brkaysenturk/turret-fcs/analysis/figures/fig2_tuned_phase_plane_portrait.png

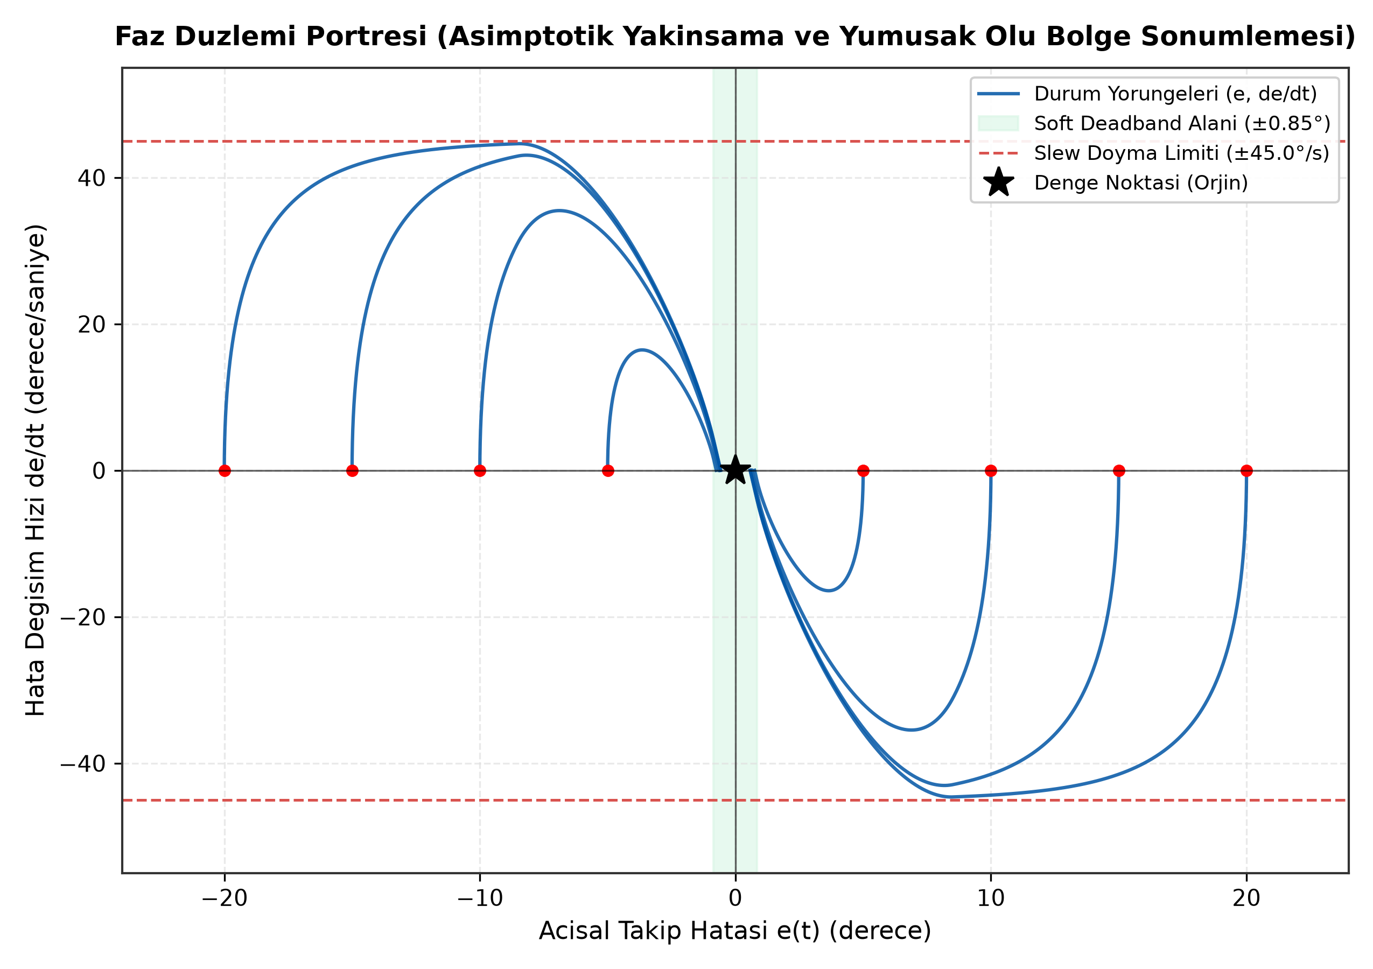
analysis/figures/fig2_tuned_phase_plane_portrait.png
