brkaysenturk/turret-fcs/analysis/figures/fig3_tuned_bode_stability.png

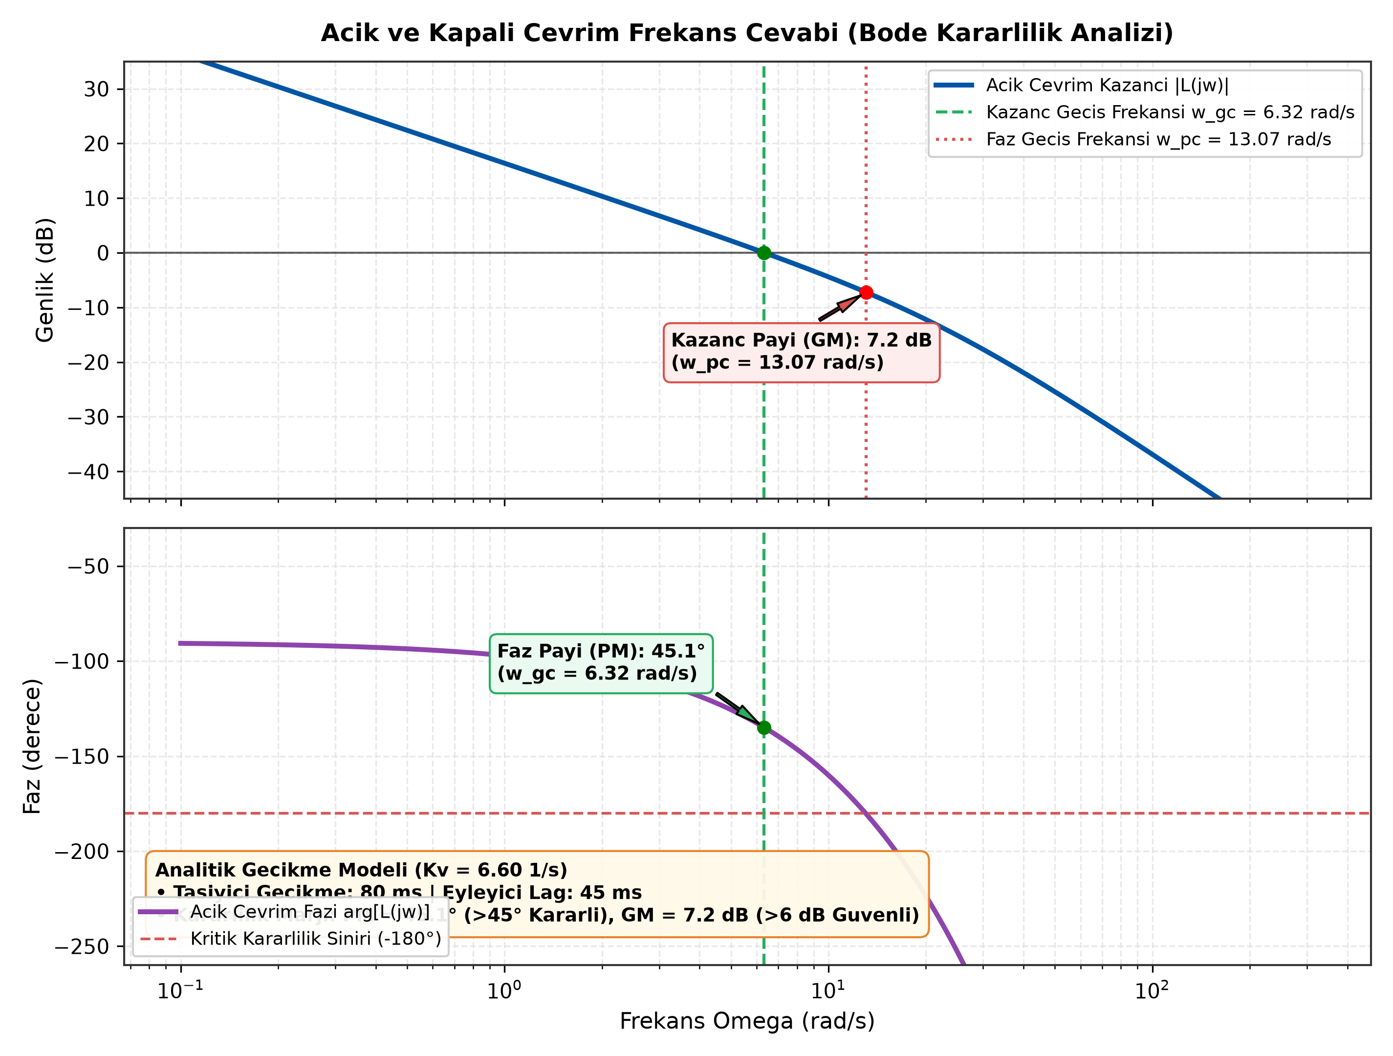
analysis/figures/fig3_tuned_bode_stability.png
