brkaysenturk/turret-fcs/analysis/figures/fig4_tuned_dynamic_tracking.png

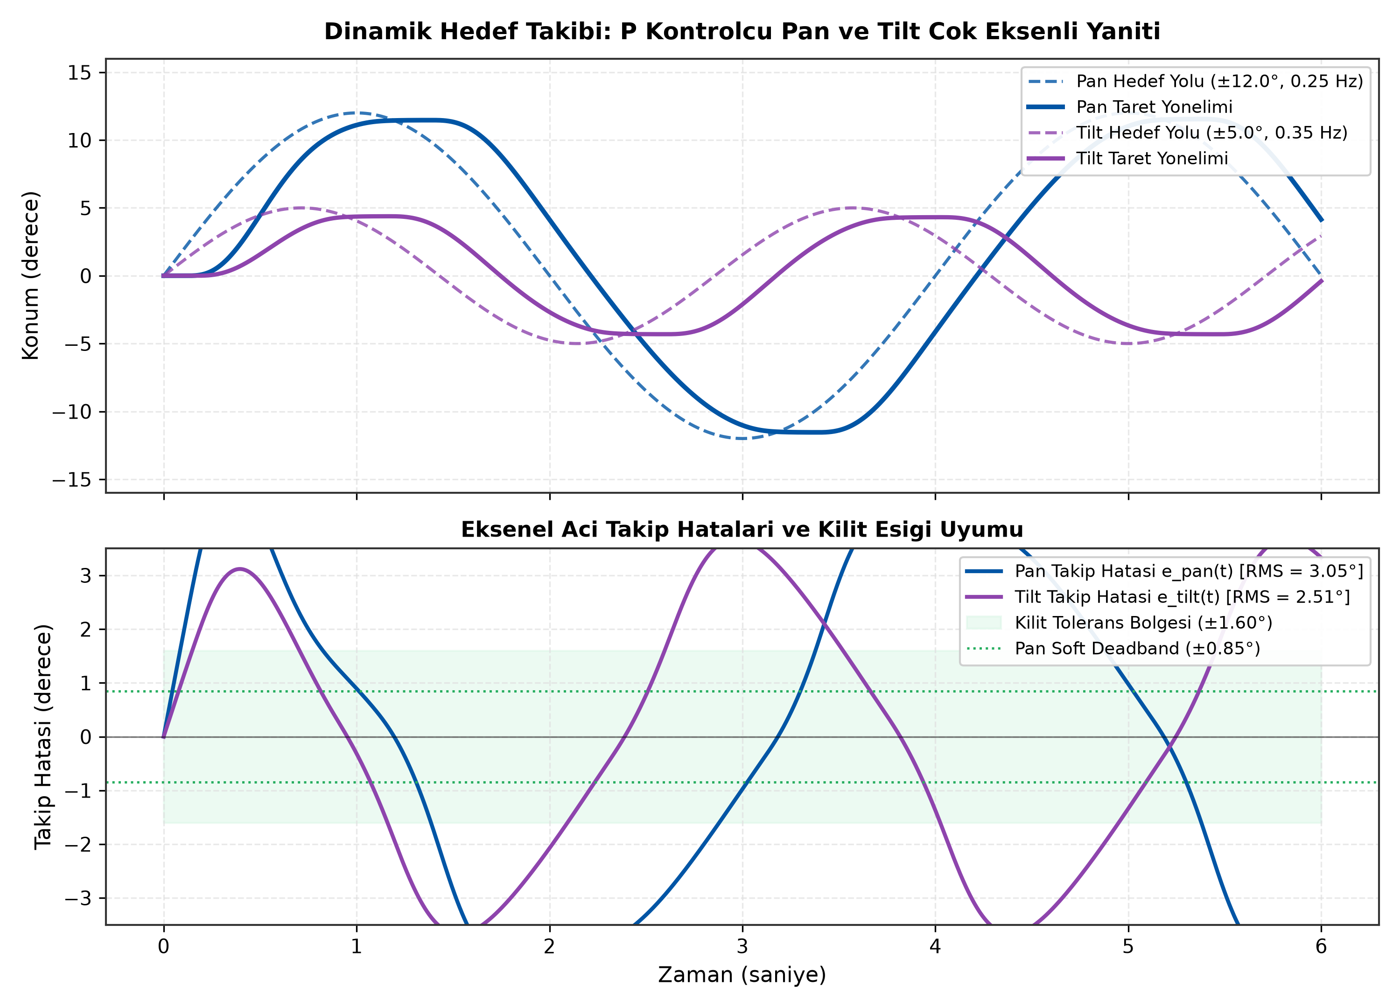
analysis/figures/fig4_tuned_dynamic_tracking.png
