brkaysenturk/turret-fcs/analysis/figures/fig5_tuned_lissajous_coverage.png

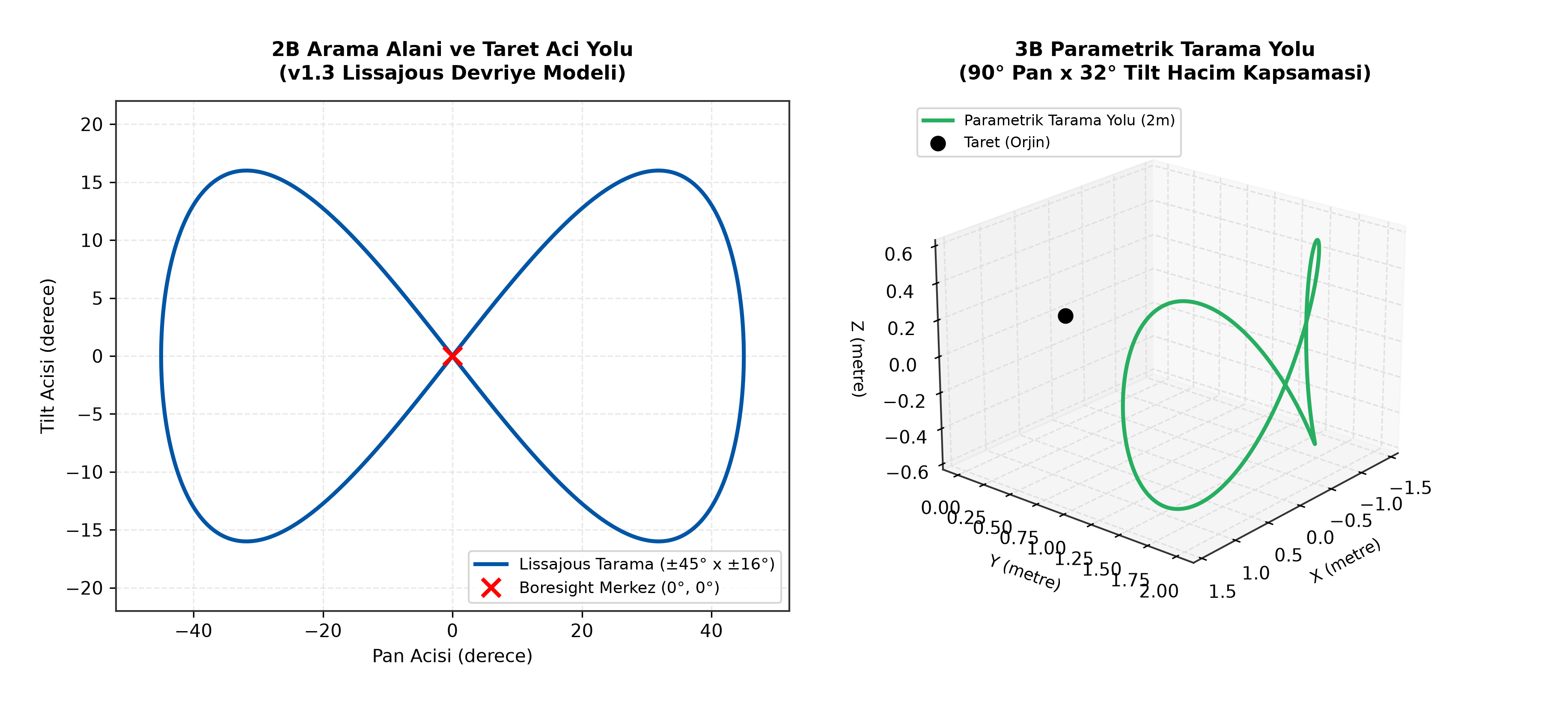
analysis/figures/fig5_tuned_lissajous_coverage.png
