brkaysenturk/turret-fcs/analysis/figures/fig7_real_hardware_still_lock.png

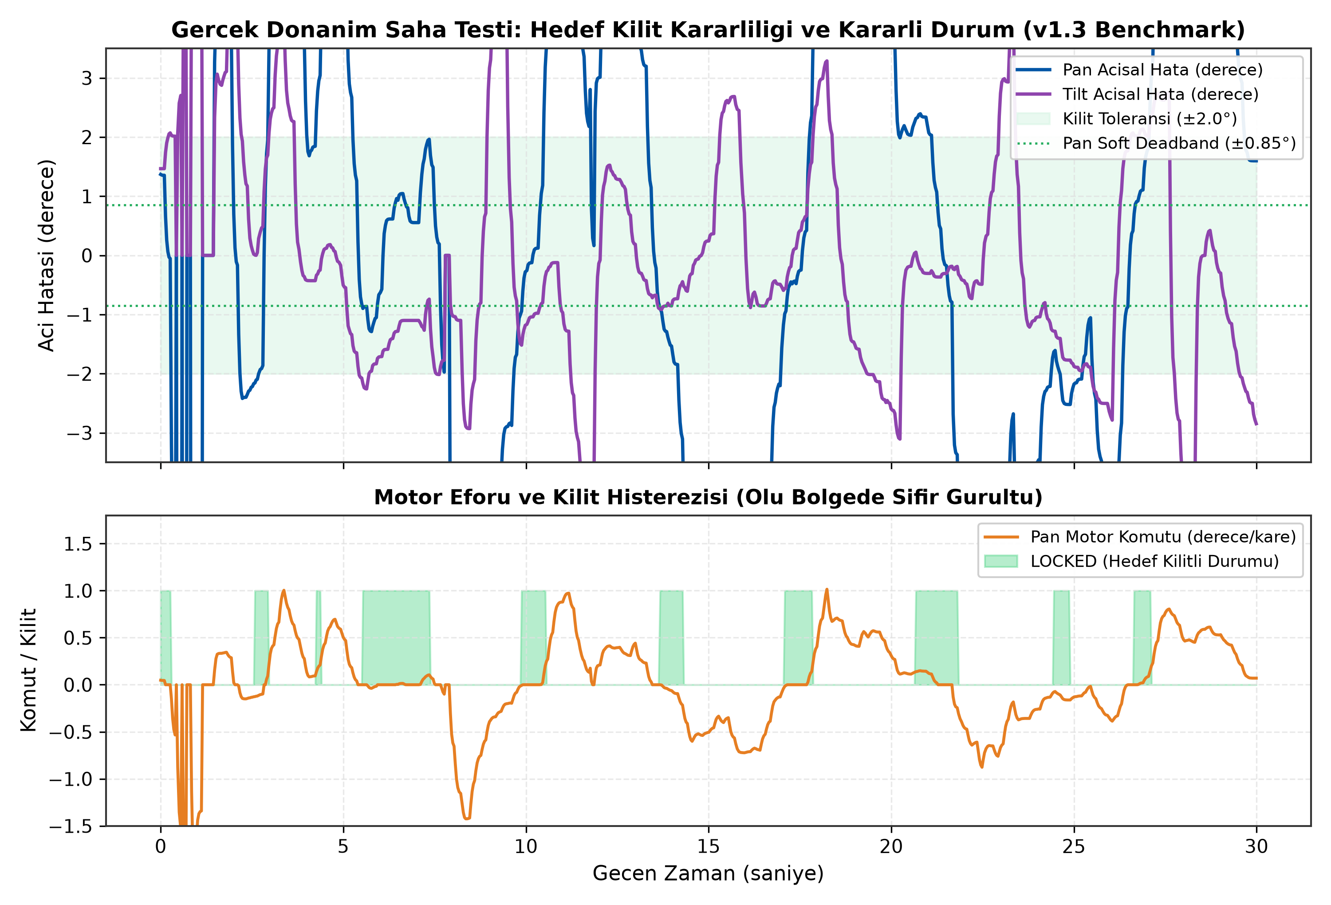
analysis/figures/fig7_real_hardware_still_lock.png
