brkaysenturk/turret-fcs/analysis/figures/fig8_real_hardware_moving_tracking.png

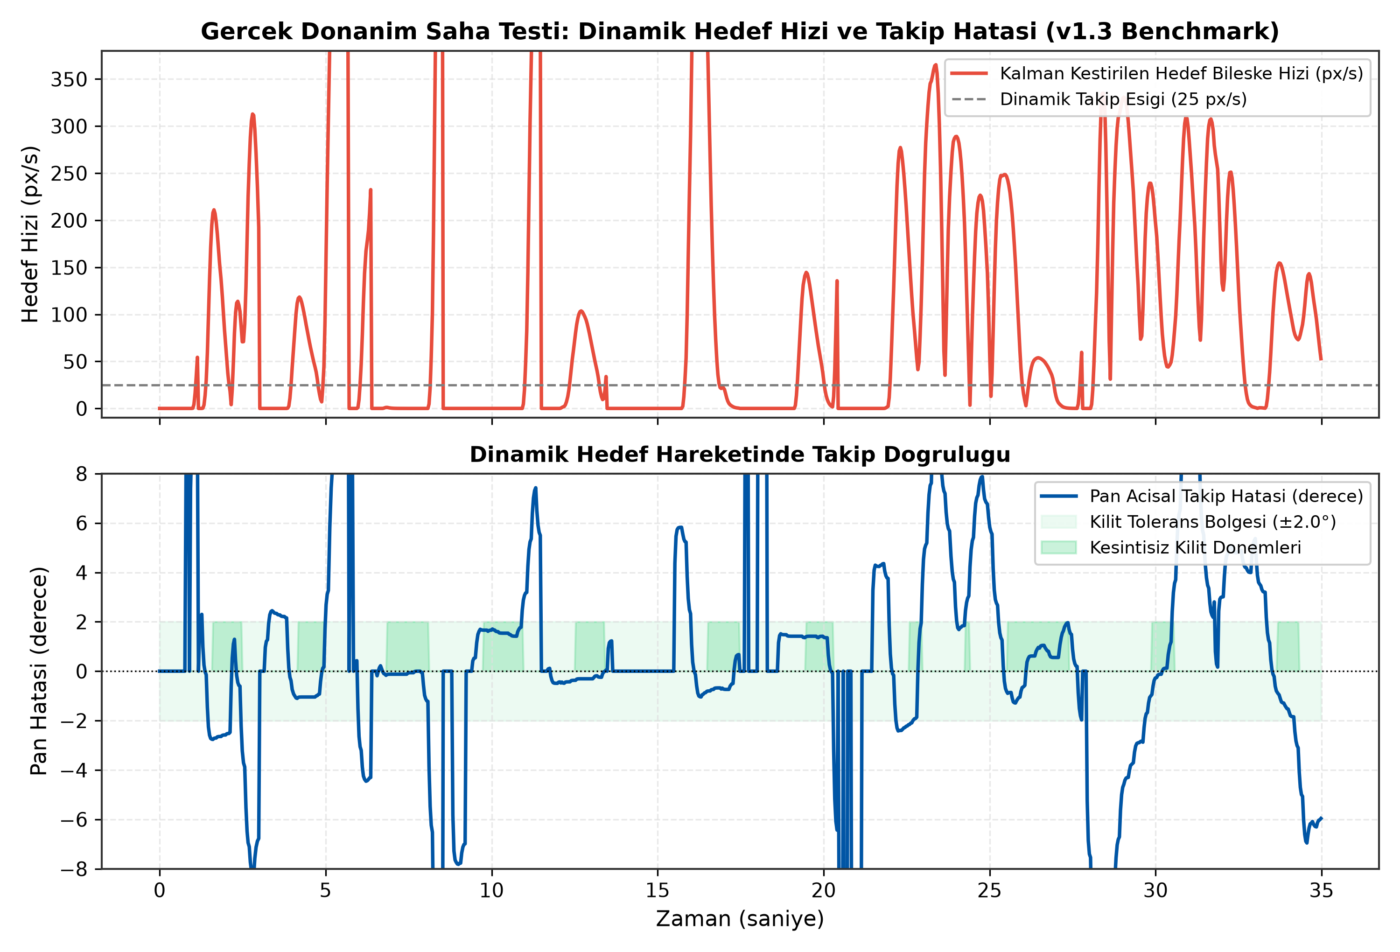
analysis/figures/fig8_real_hardware_moving_tracking.png
