brkaysenturk/turret-fcs/analysis/figures/fig8_sim_moving_tracking.png

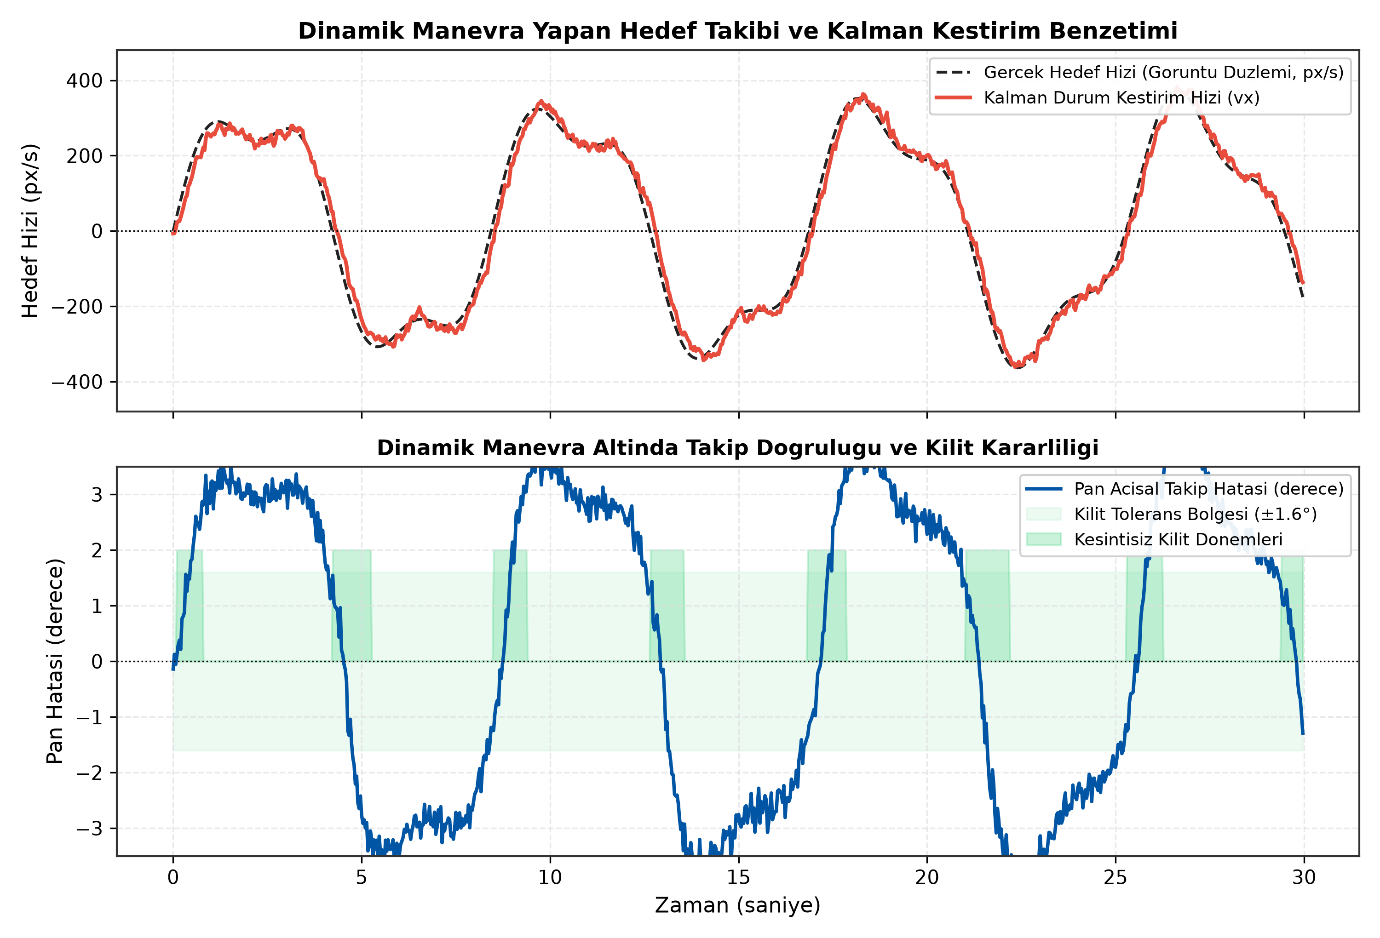
analysis/figures/fig8_sim_moving_tracking.png
