brkaysenturk/turret-fcs/analysis/figures/fig8_system_identification.png

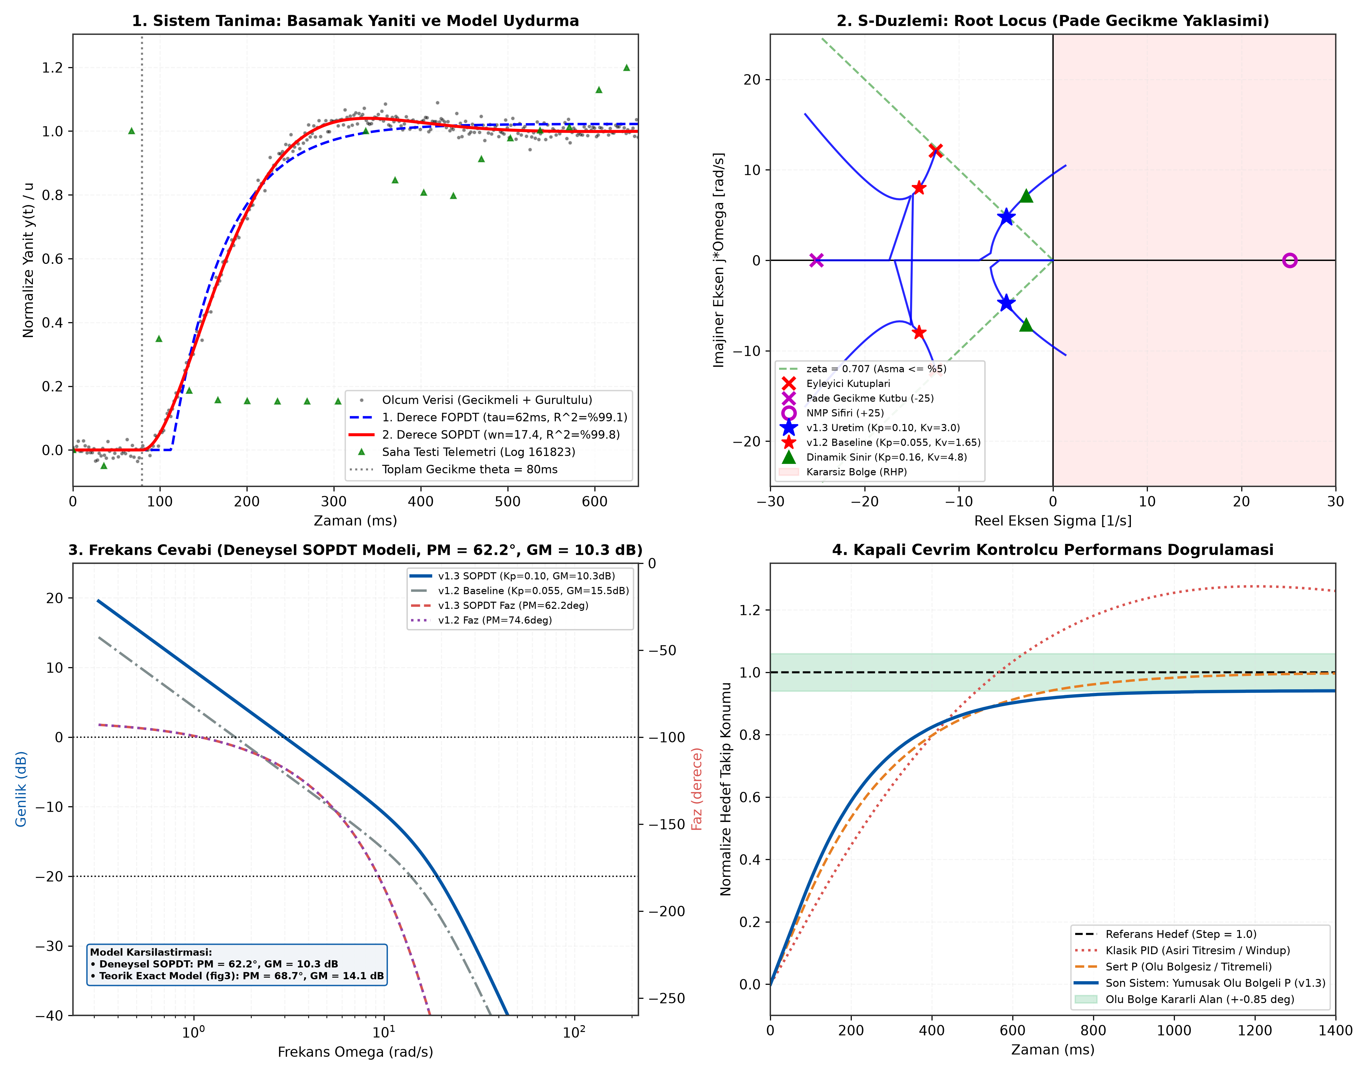
analysis/figures/fig8_system_identification.png
