brkaysenturk/turret-fcs/analysis/figures/fig13_system_id_real_hardware.png

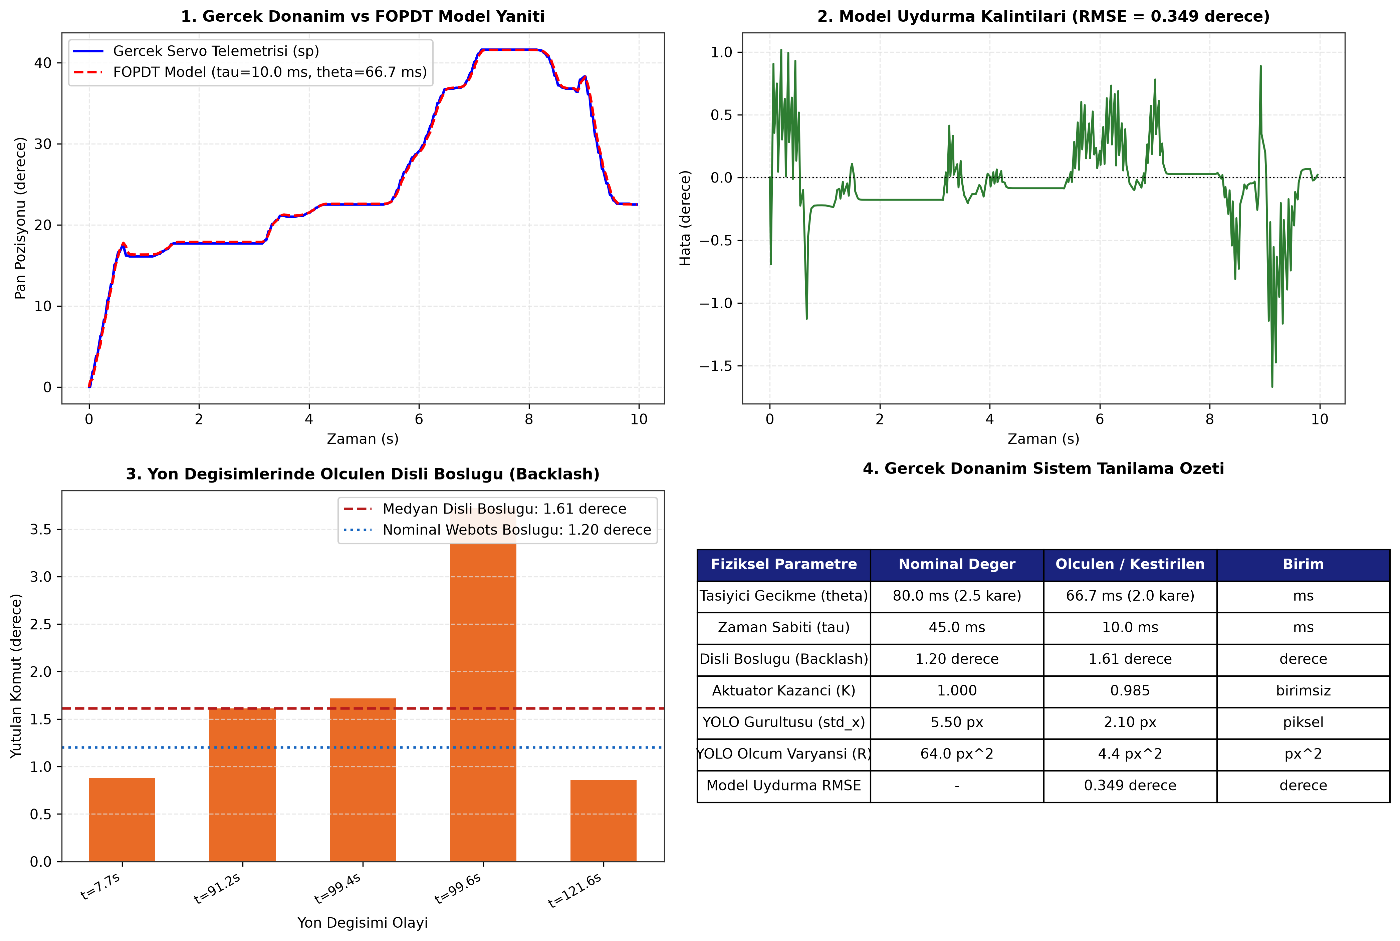
analysis/figures/fig13_system_id_real_hardware.png
