brkaysenturk/turret-fcs/analysis/figures/lissajous_patrol_simulation.png

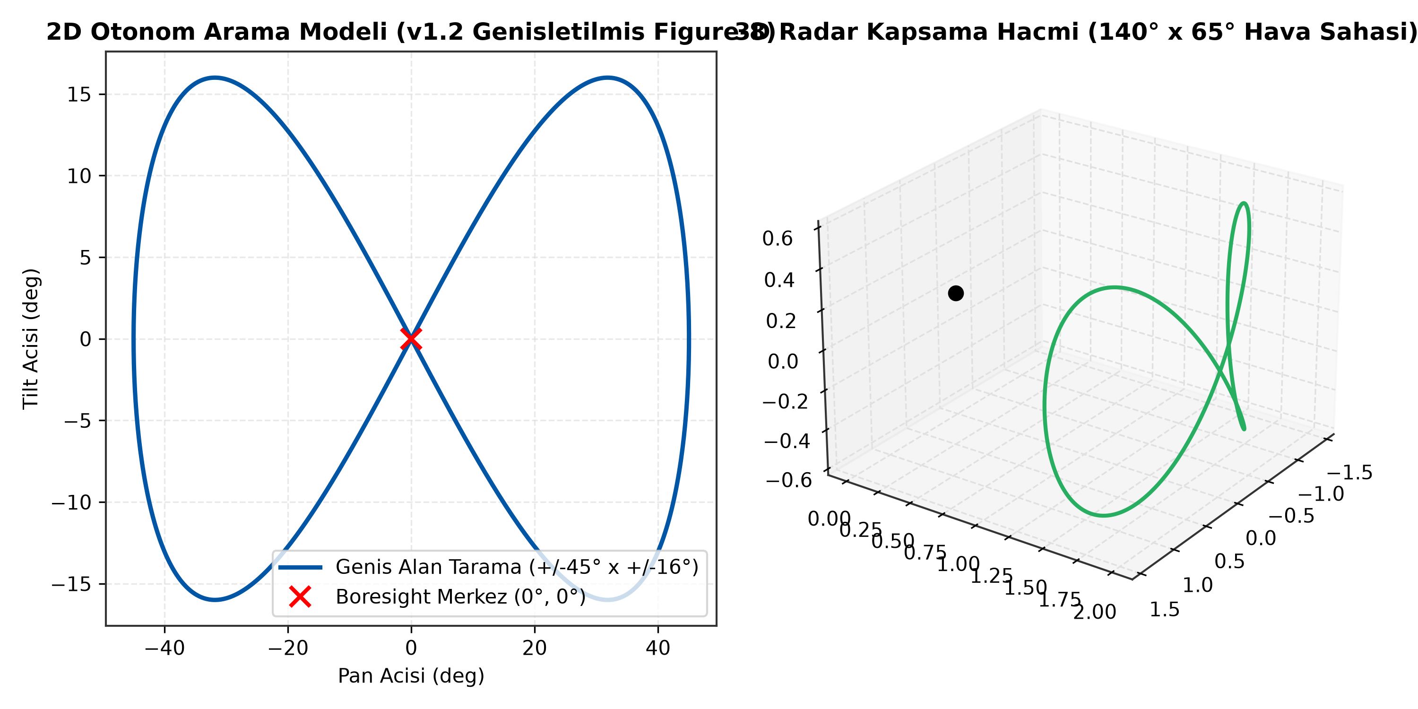
analysis/figures/lissajous_patrol_simulation.png
