brkaysenturk/turret-fcs/analysis/figures/patrol_kinematic_telemetry_analysis.png

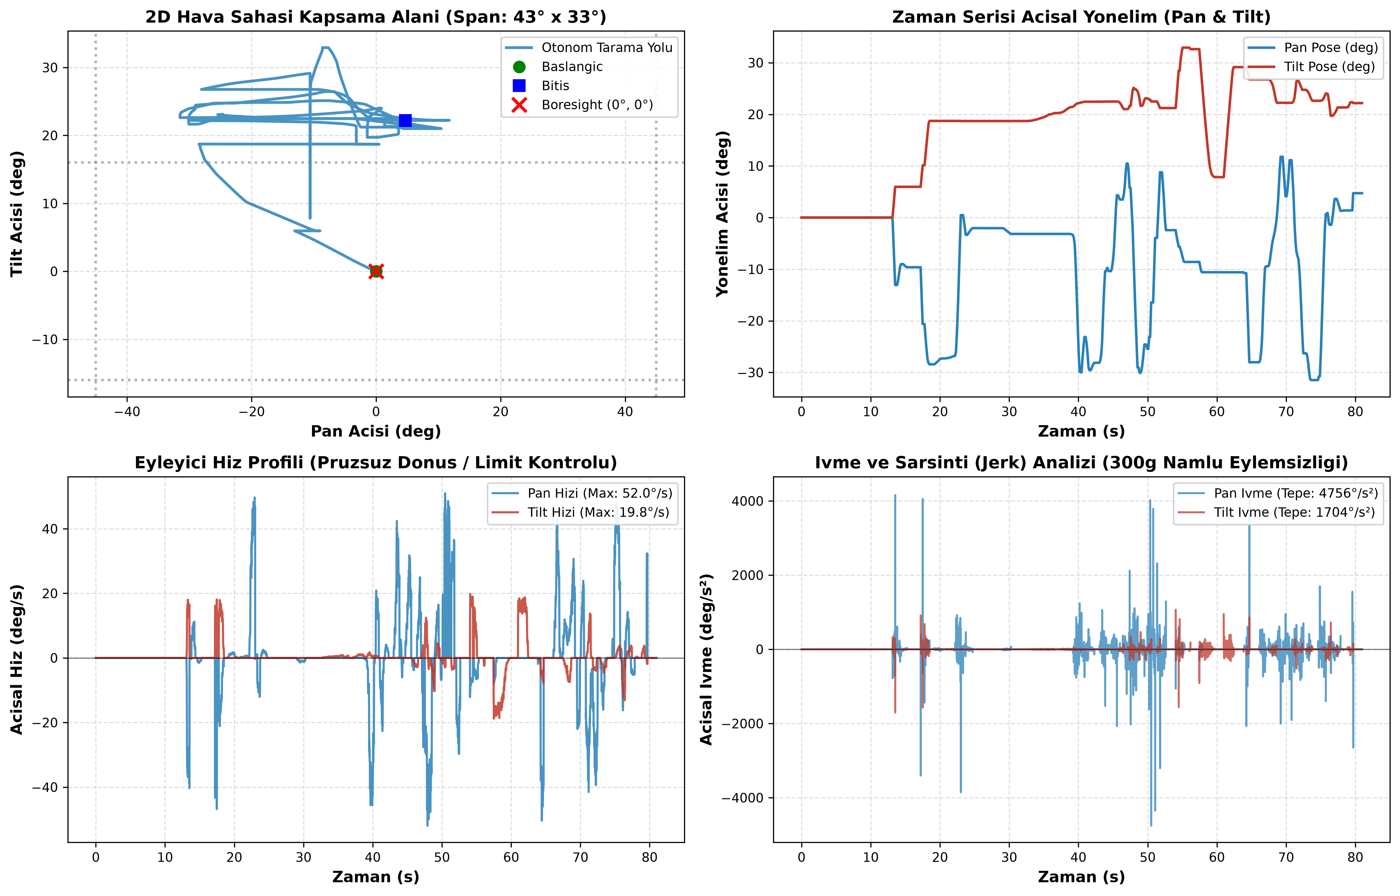
analysis/figures/patrol_kinematic_telemetry_analysis.png
