brkaysenturk/turret-fcs/analysis/figures/python/python_fig15_patrol_kinematic_telemetry.png

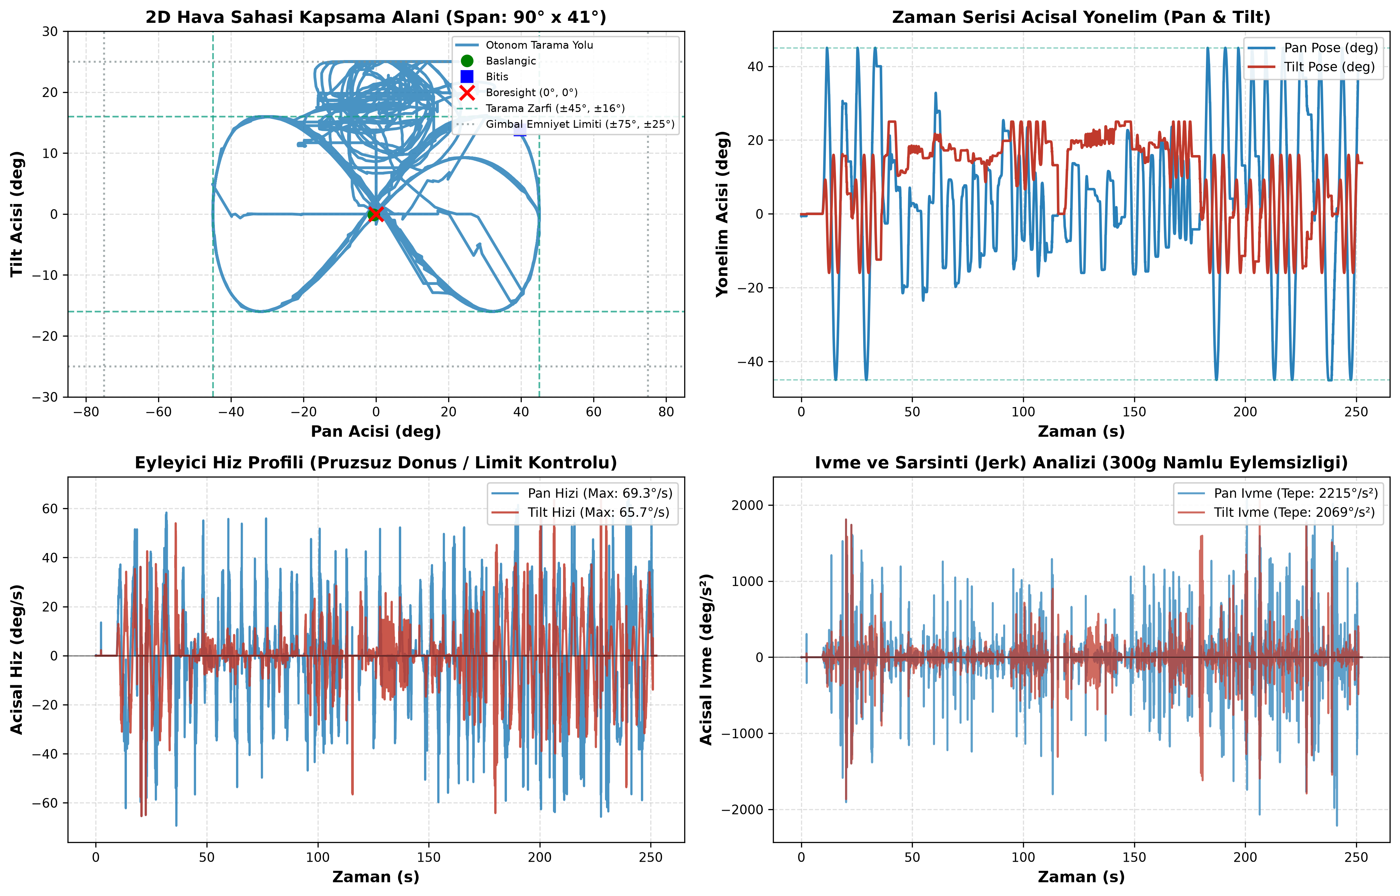
analysis/figures/python/python_fig15_patrol_kinematic_telemetry.png
