brkaysenturk/turret-fcs/docs/assets/stm32_architecture.png

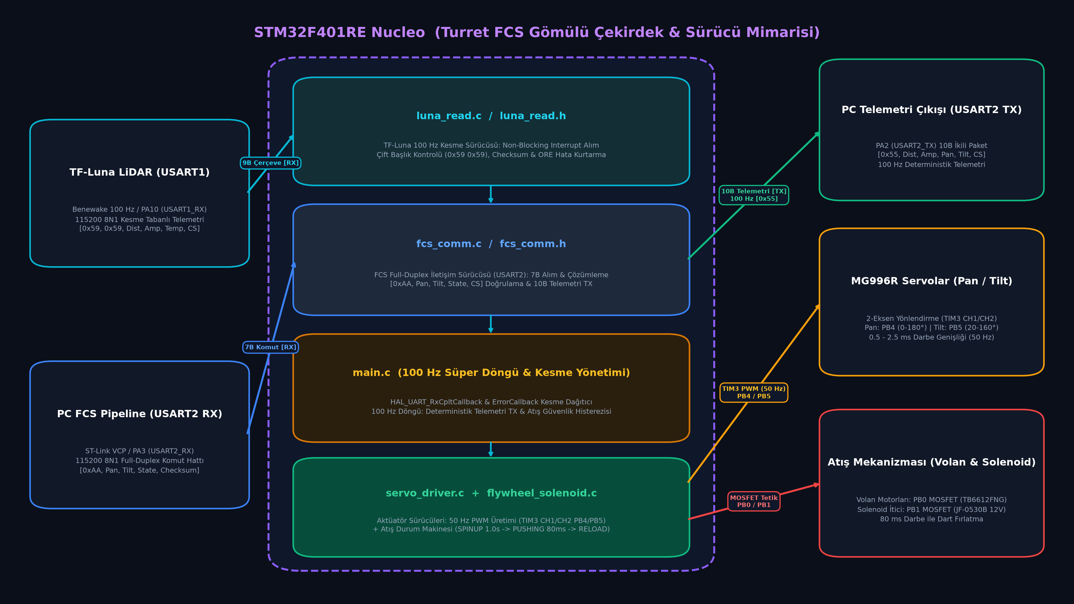
docs/assets/stm32_architecture.png
