brkaysenturk/turret-fcs/docs/assets/turret_fcs_architecture.png

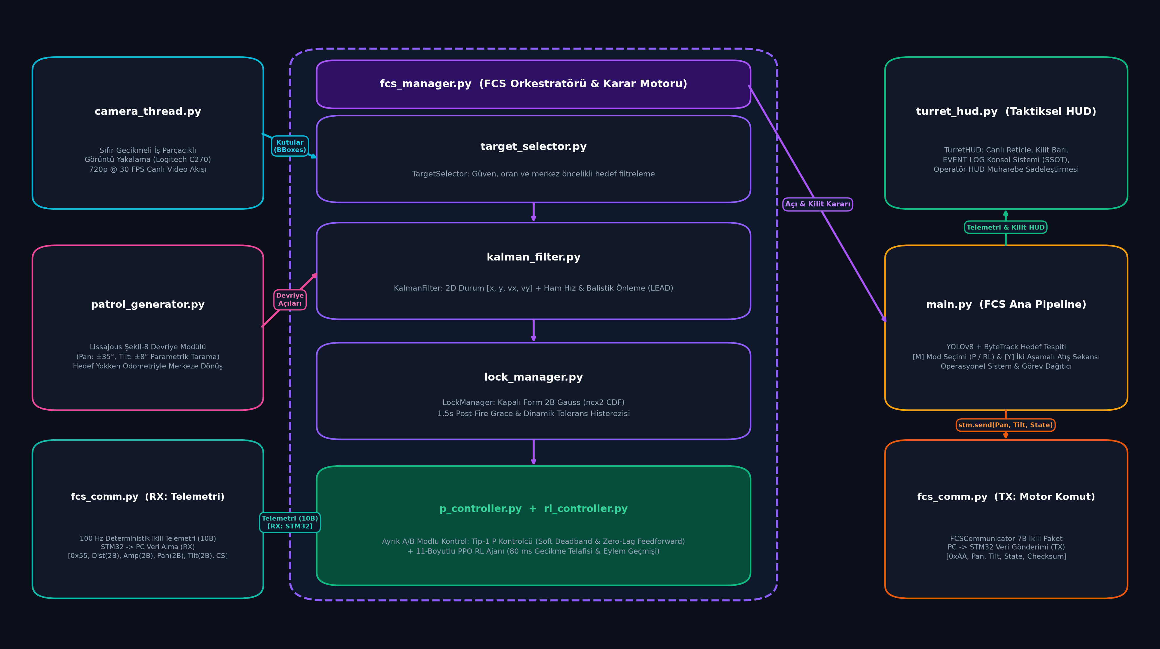
docs/assets/turret_fcs_architecture.png
