brkaysenturk/turret-fcs/docs/assets/webots_architecture.png

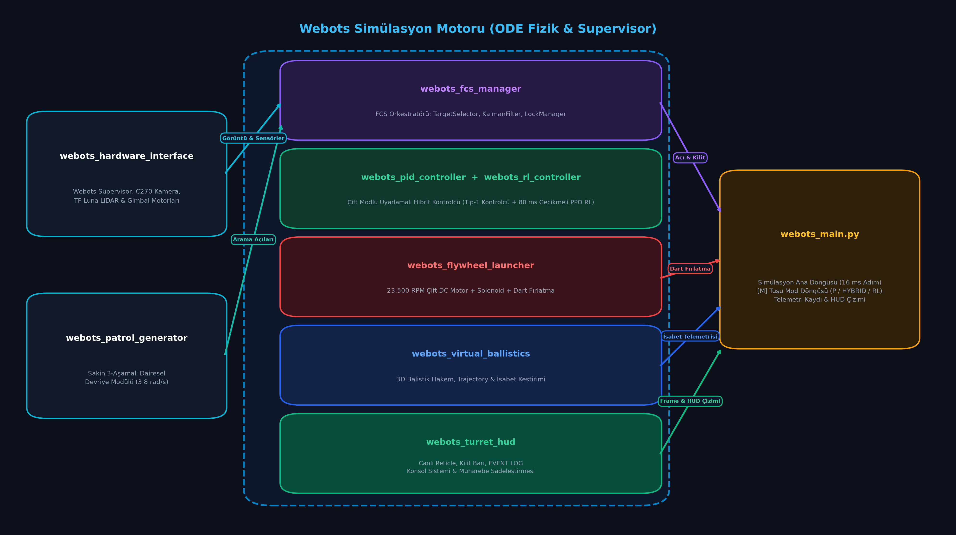
docs/assets/webots_architecture.png
