brkaysenturk/turret-fcs/turret_basket/analysis/baseline_vs_24_basket_table_comparison.png

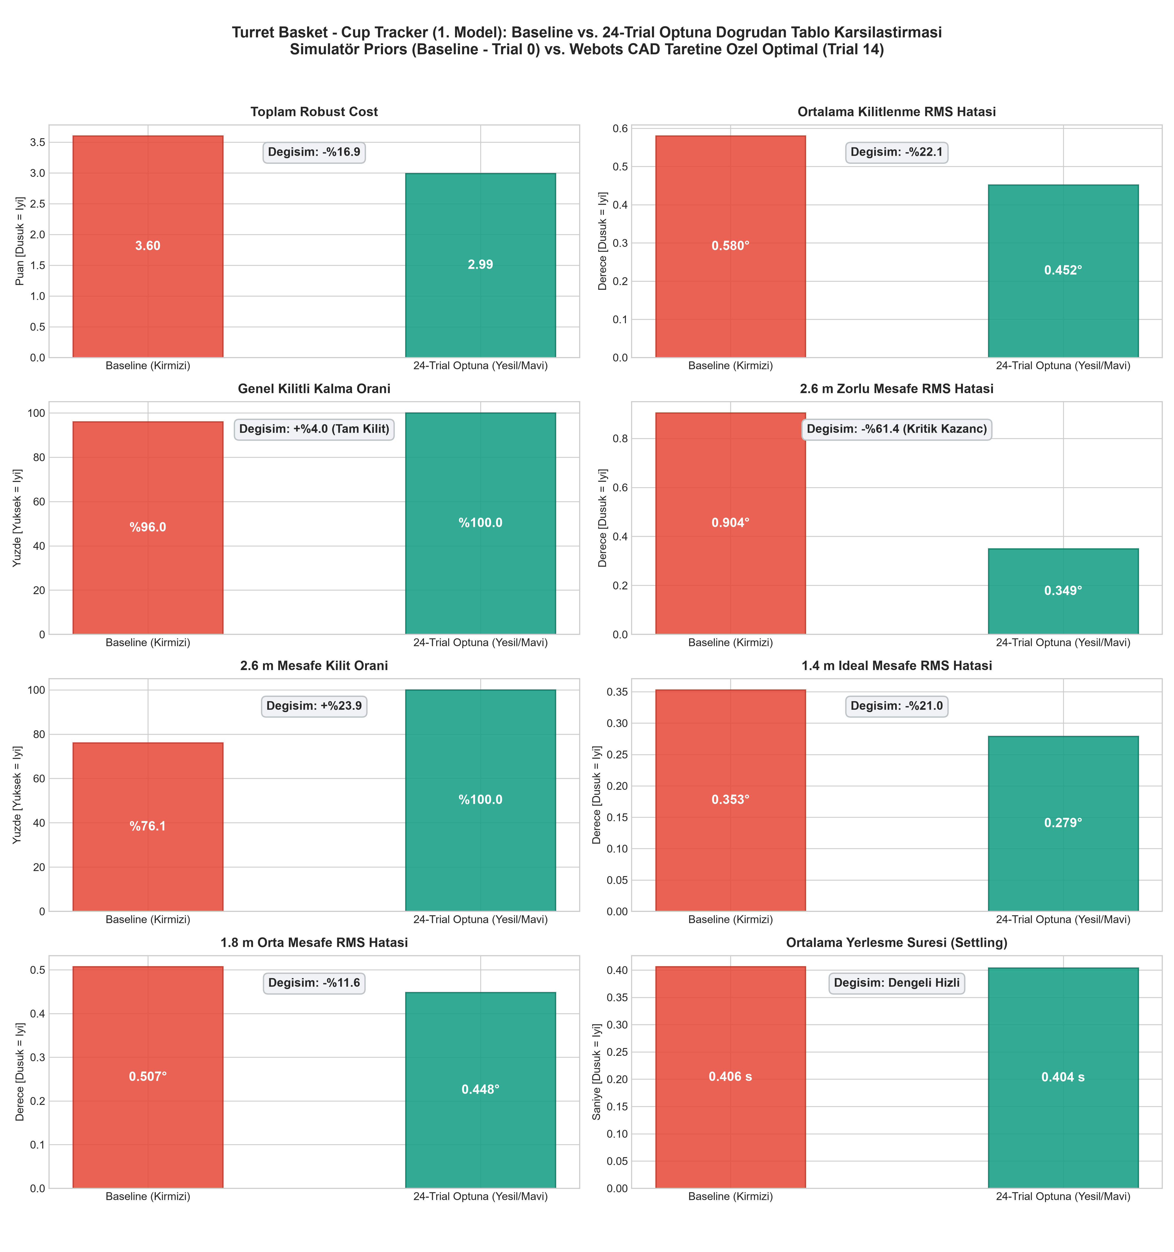
turret_basket/analysis/baseline_vs_24_basket_table_comparison.png
