brkaysenturk/turret-fcs/turret_basket/analysis/cup_tracker_trial_comparison.png

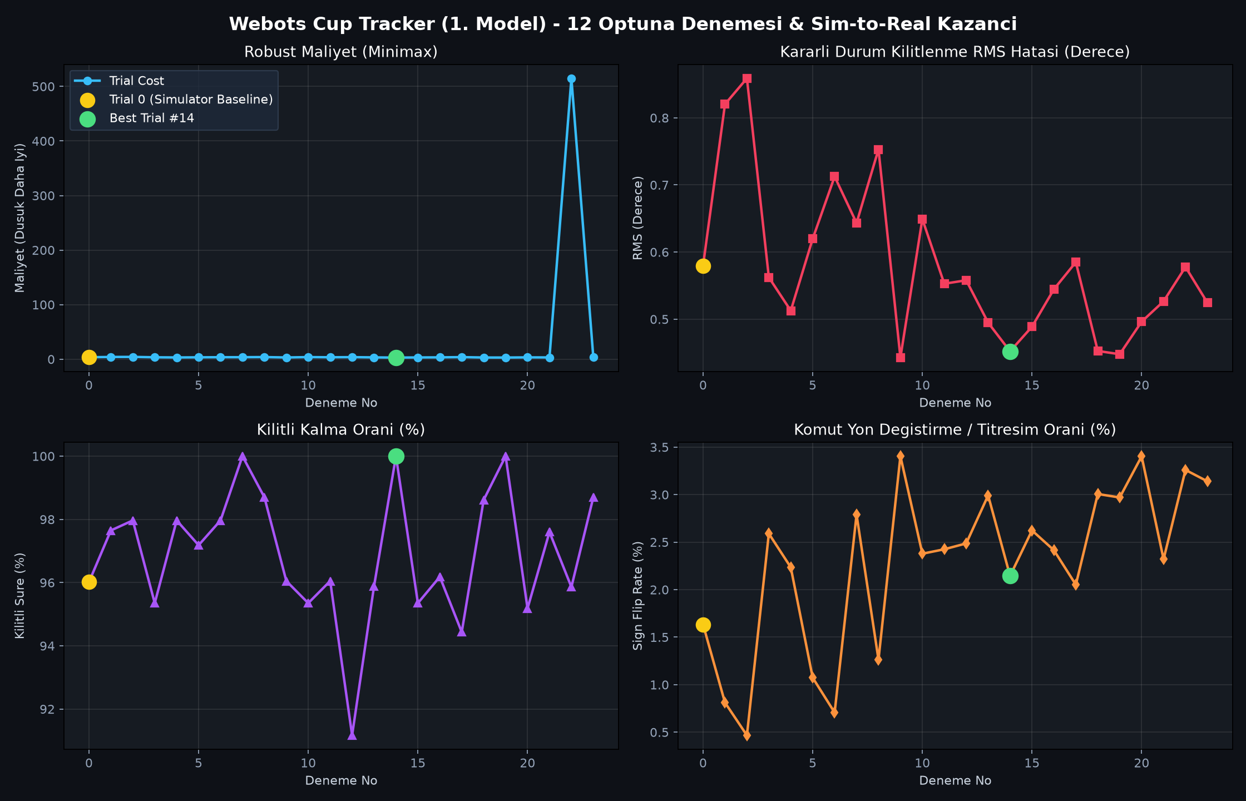
turret_basket/analysis/cup_tracker_trial_comparison.png
