brkaysenturk/turret-fcs/turret_basket/analysis/figures/python/python_fig1_ballistic_trajectories_rk4.png

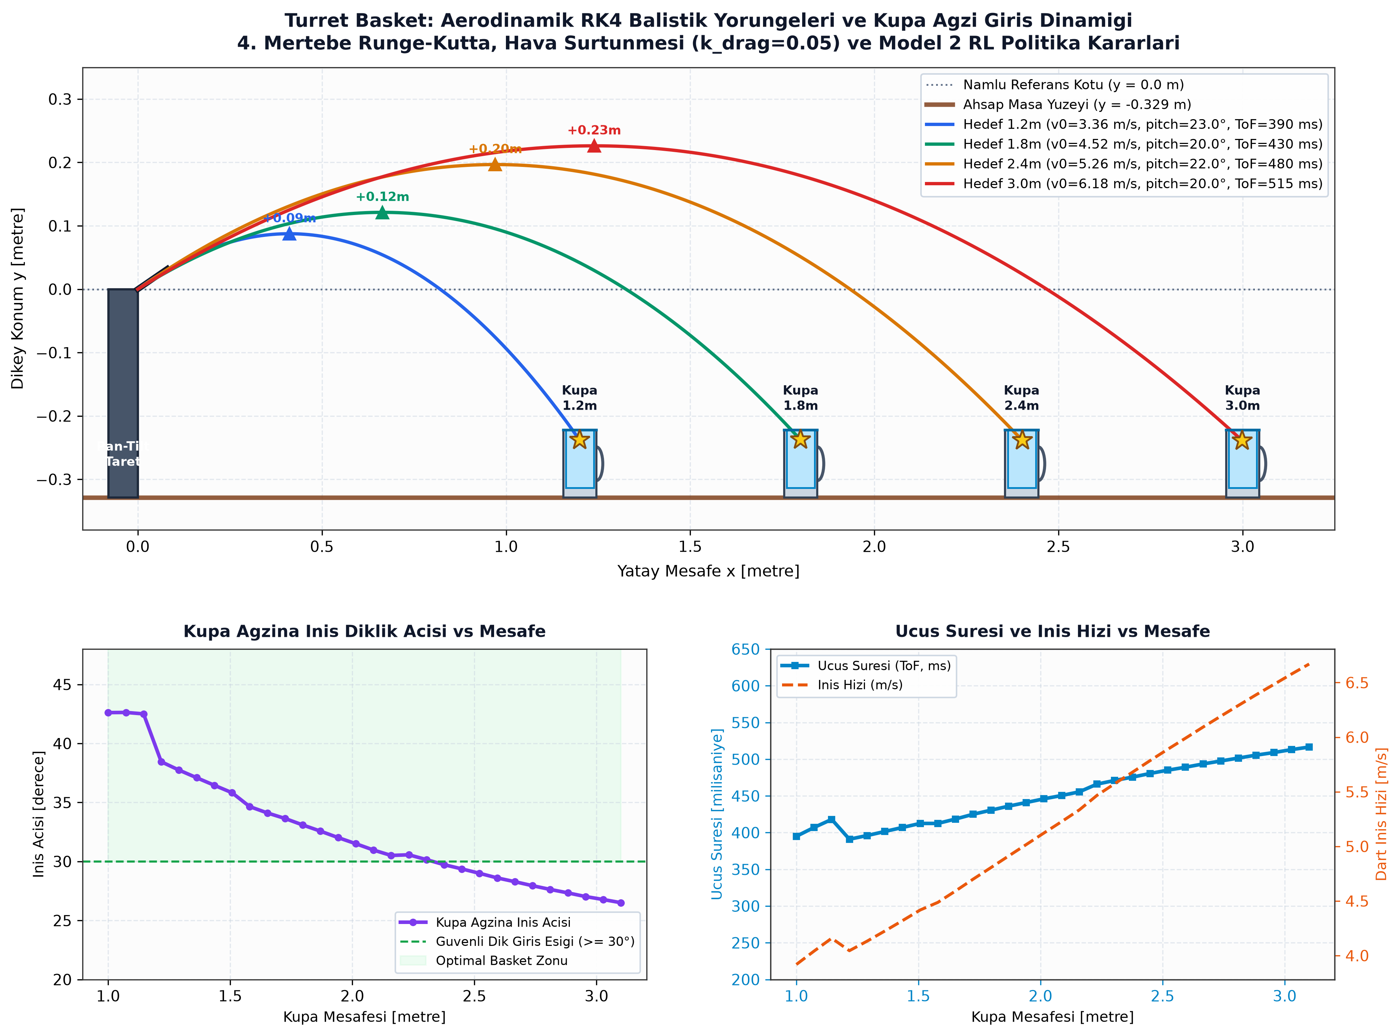
turret_basket/analysis/figures/python/python_fig1_ballistic_trajectories_rk4.png
