brkaysenturk/turret-fcs/turret_basket/analysis/figures/python/python_fig2_rl_ballistics_policy_decision.png

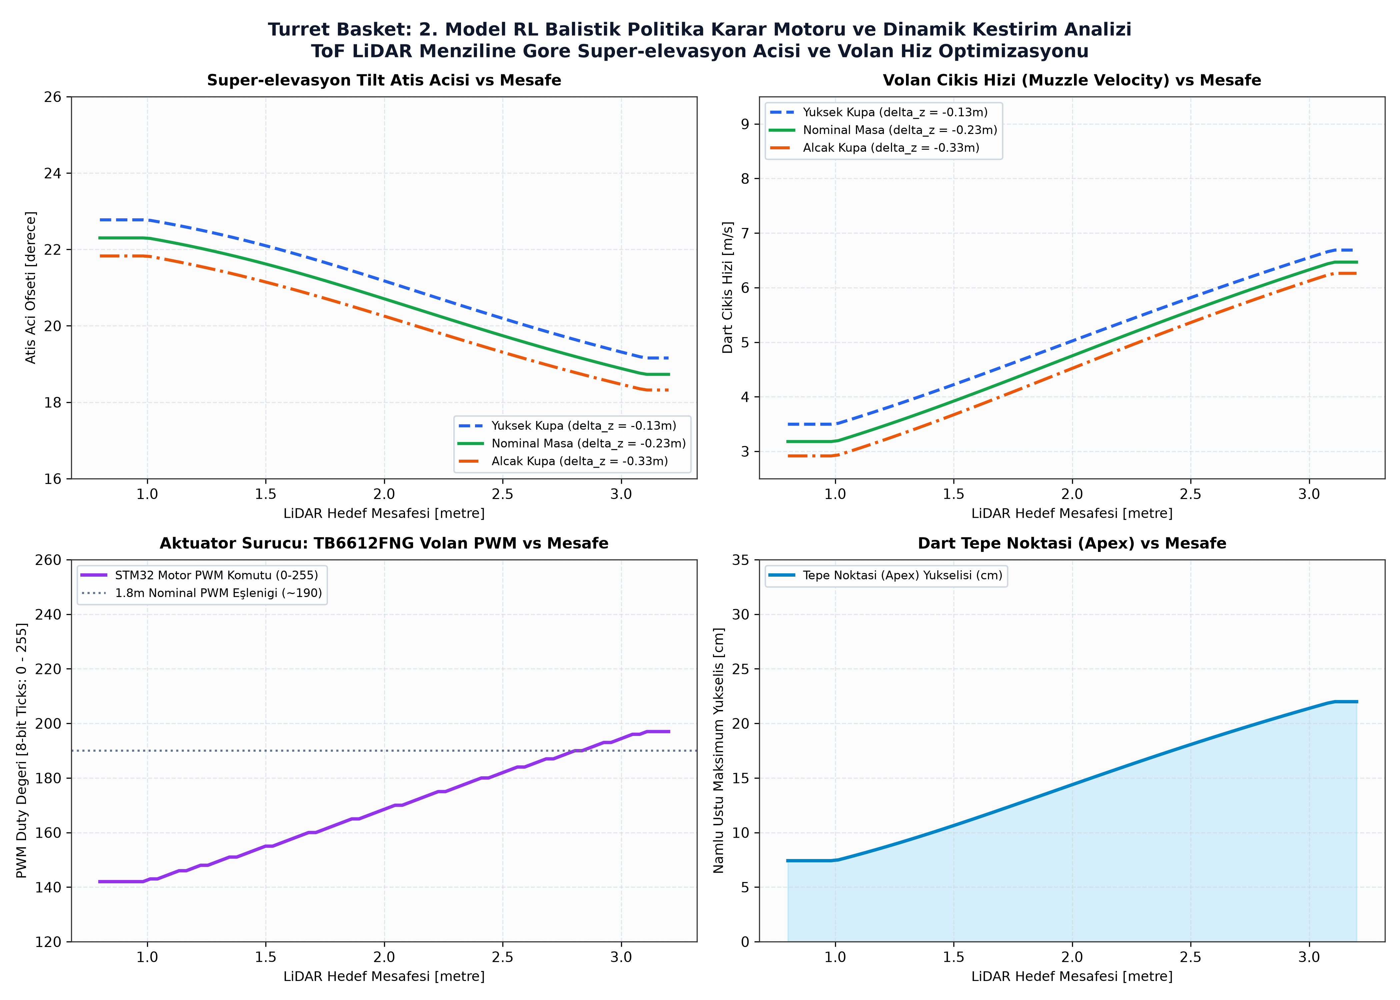
turret_basket/analysis/figures/python/python_fig2_rl_ballistics_policy_decision.png
