brkaysenturk/turret-fcs/turret_basket/analysis/figures/python/python_fig3_basket_tolerance_heatmap.png

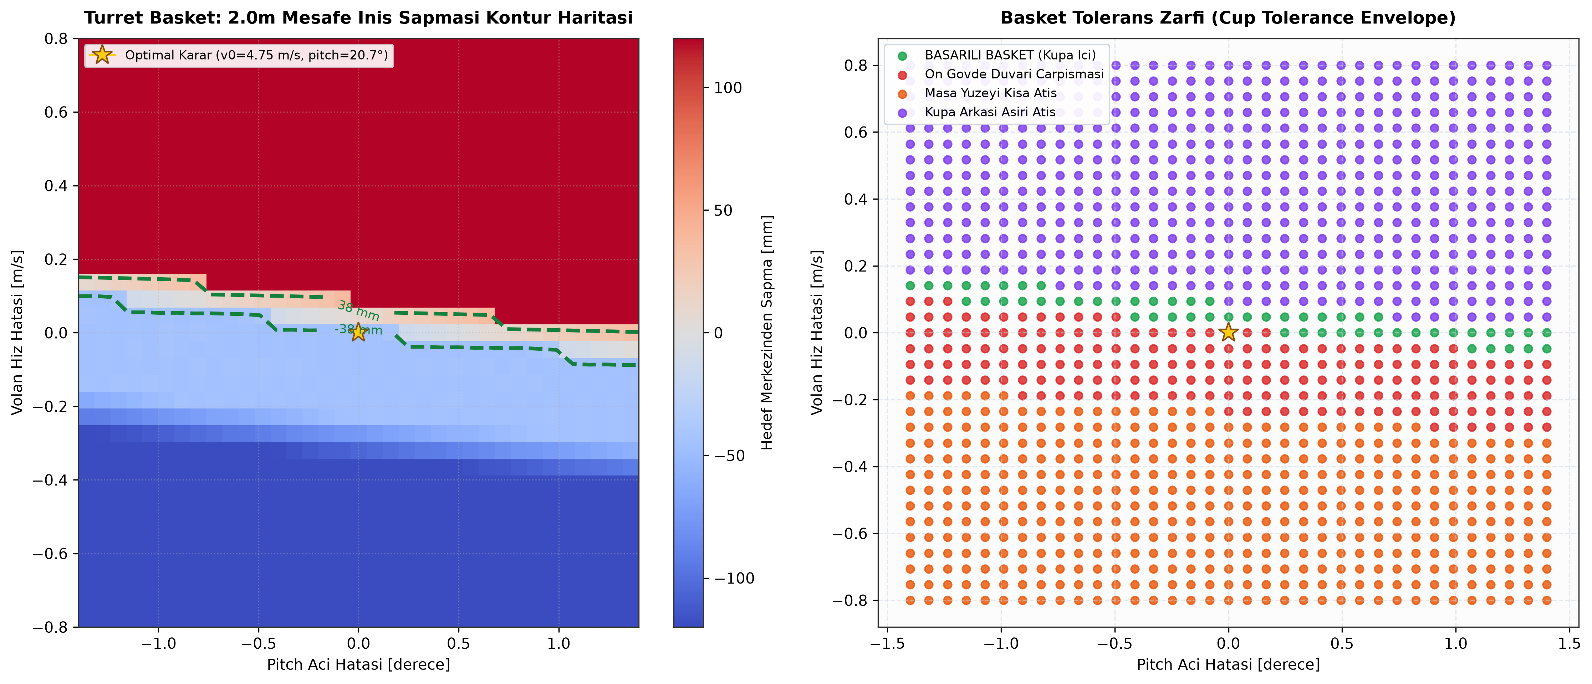
turret_basket/analysis/figures/python/python_fig3_basket_tolerance_heatmap.png
