brkaysenturk/turret-fcs/turret_basket/analysis/figures/python/python_fig4_engagement_timing_profile.png

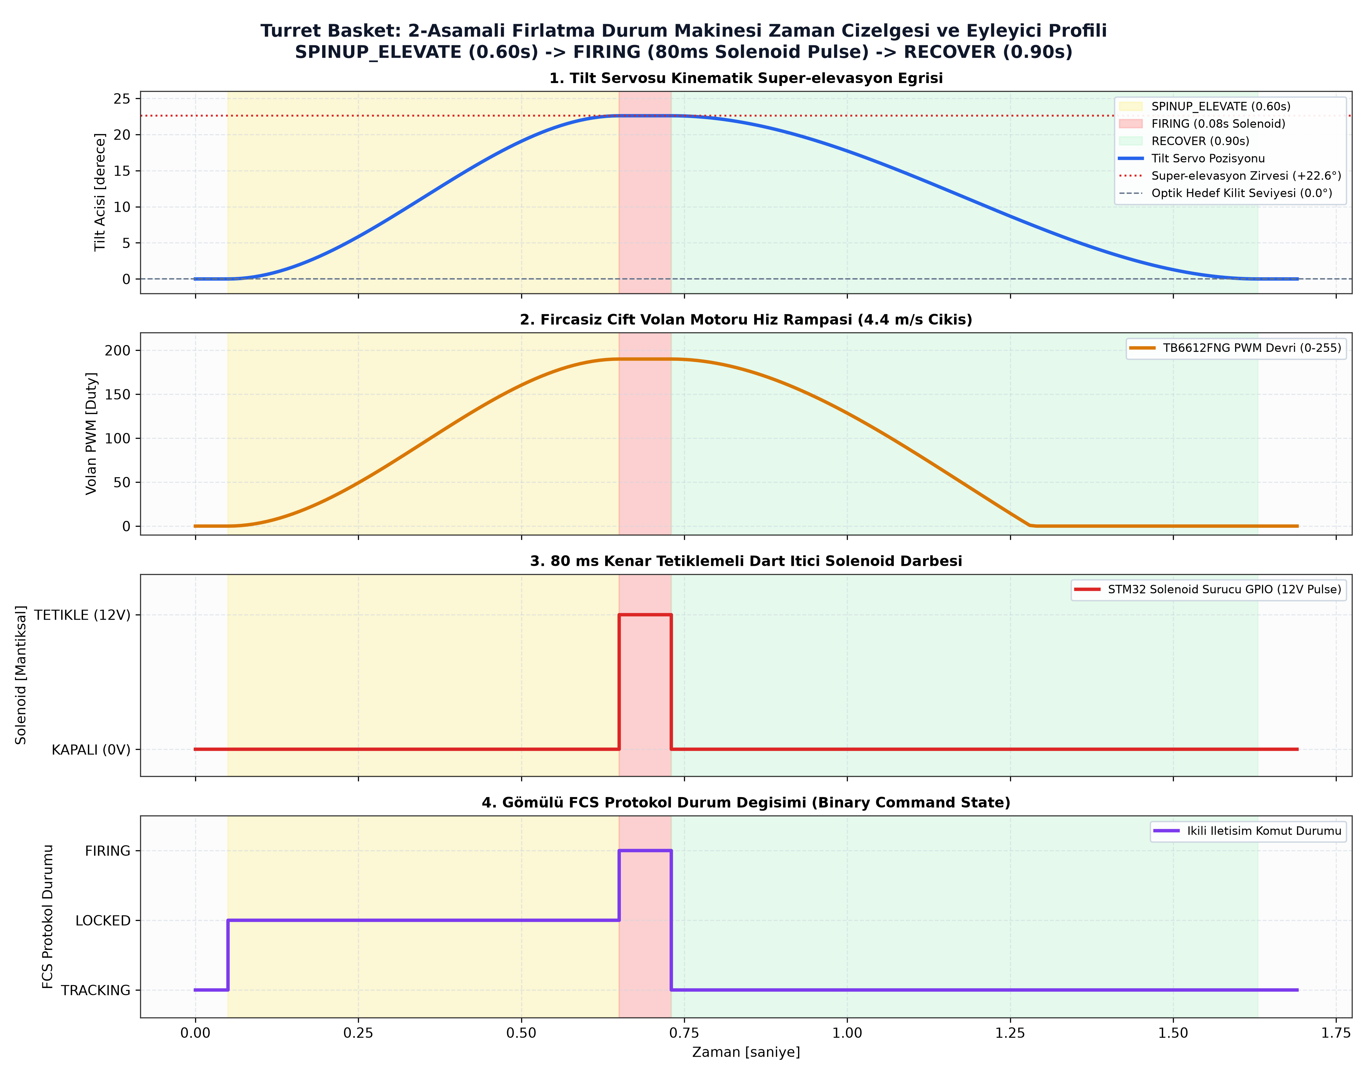
turret_basket/analysis/figures/python/python_fig4_engagement_timing_profile.png
