brkaysenturk/turret-fcs/turret_basket/analysis/figures/python/python_fig6_optuna_24trials_convergence.png

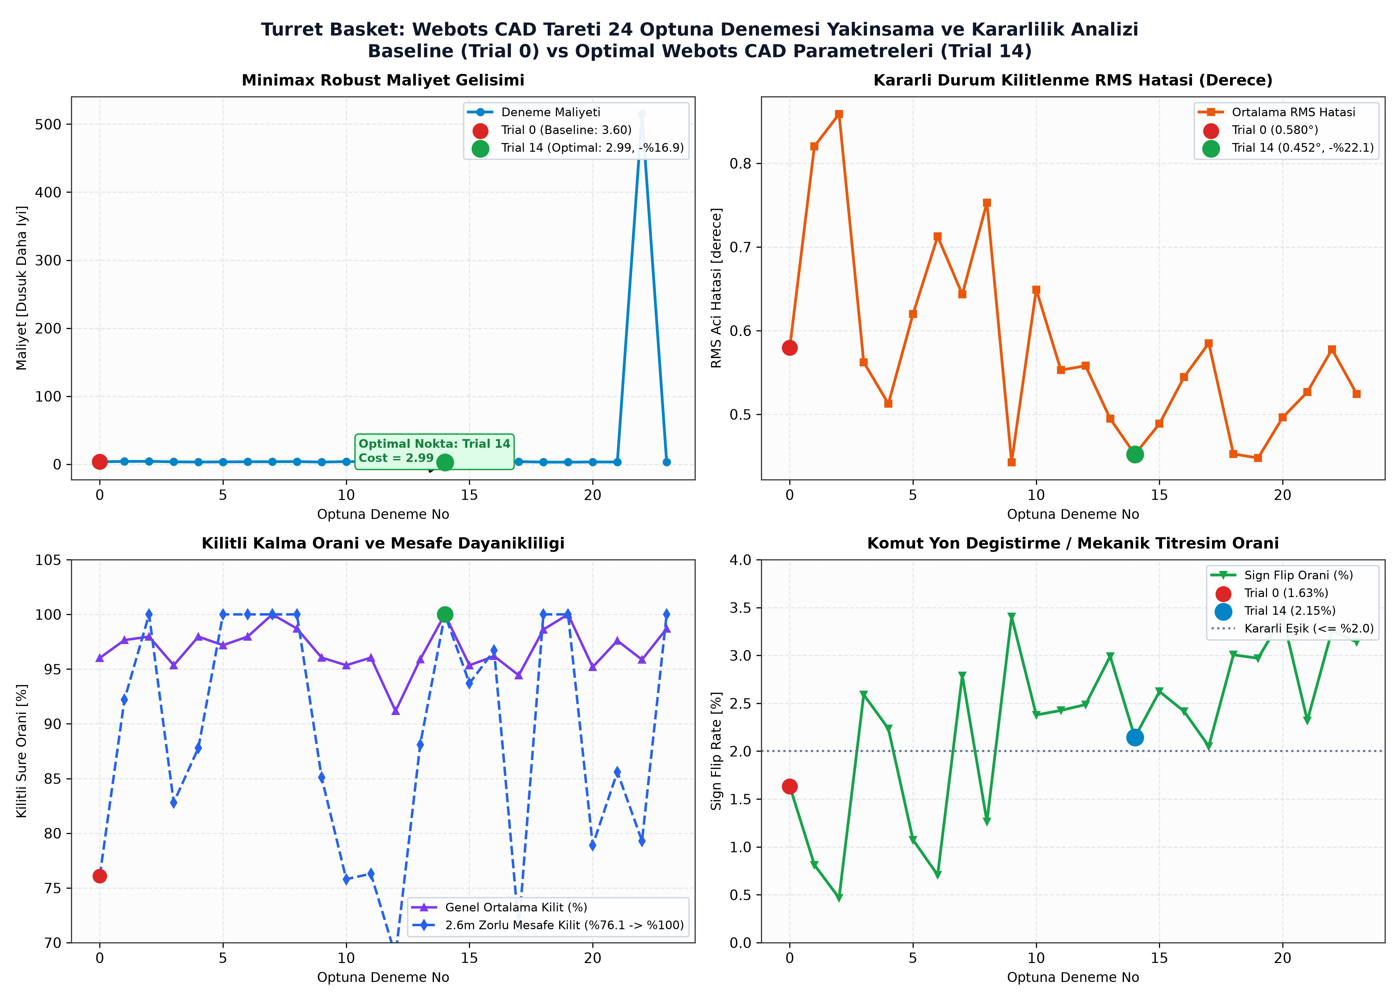
turret_basket/analysis/figures/python/python_fig6_optuna_24trials_convergence.png
