brkaysenturk/turret-fcs/turret_cad_render.jpg

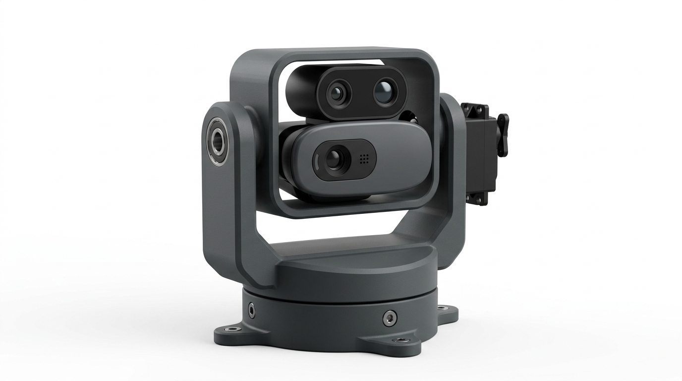
turret_cad_render.jpg
