brkaysenturk/turret-fcs/turret_cad_render_annotated.jpg

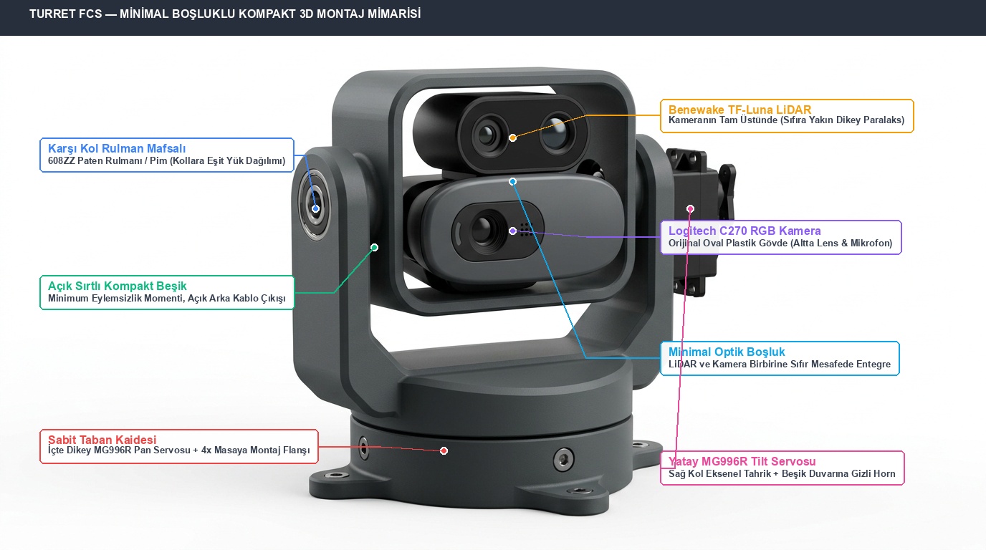
turret_cad_render_annotated.jpg
