brkaysenturk/turret-fcs/turret_fcs/analysis/comparison/baseline_vs_24_table_comparison.png

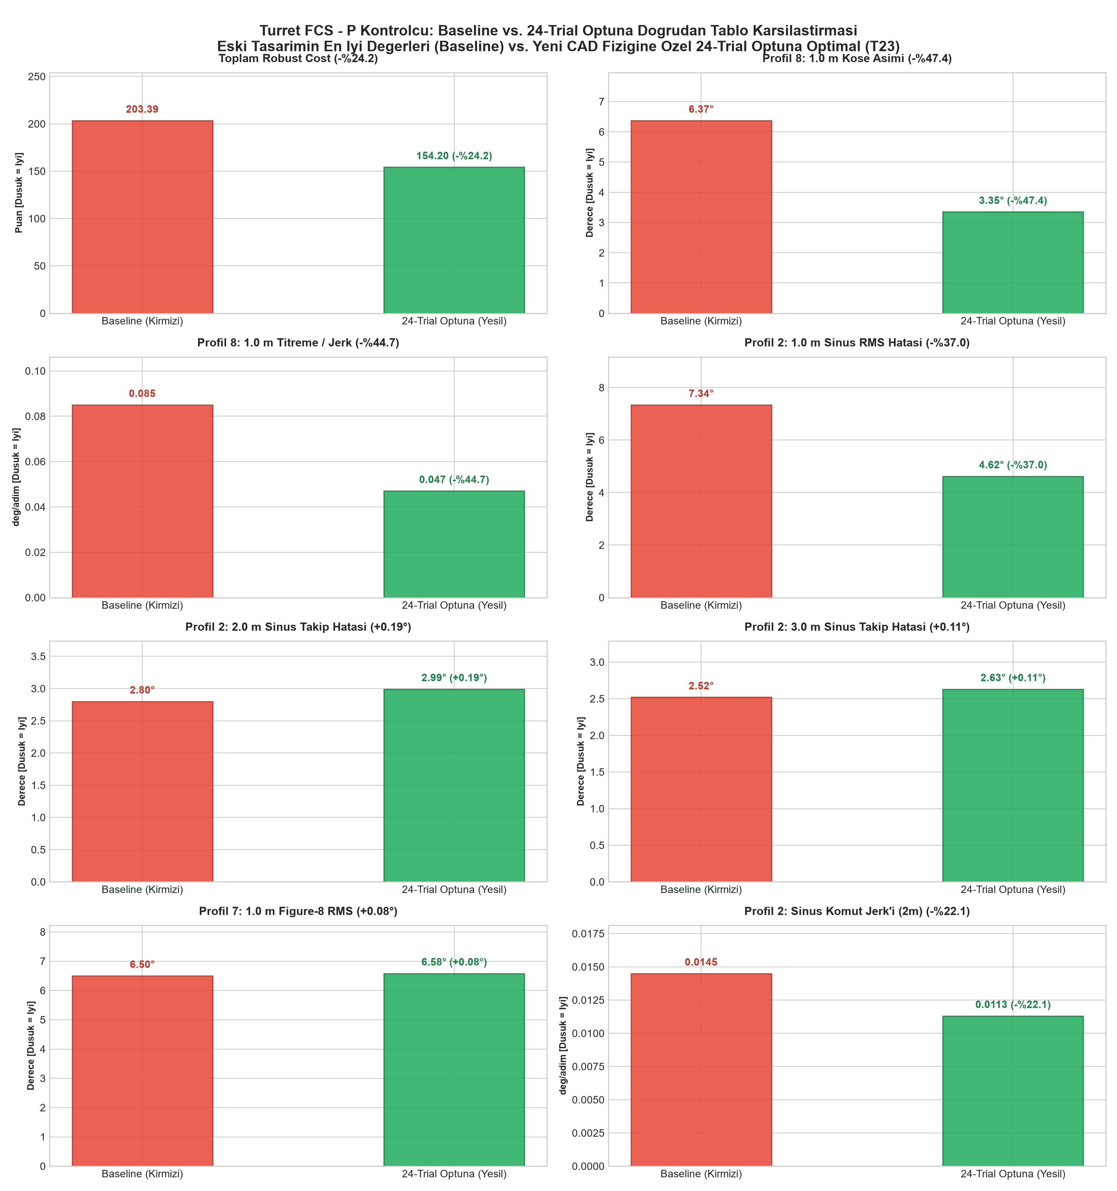
turret_fcs/analysis/comparison/baseline_vs_24_table_comparison.png
