brkaysenturk/turret-fcs/turret_fcs/analysis/comparison/distance_comparison_p.png

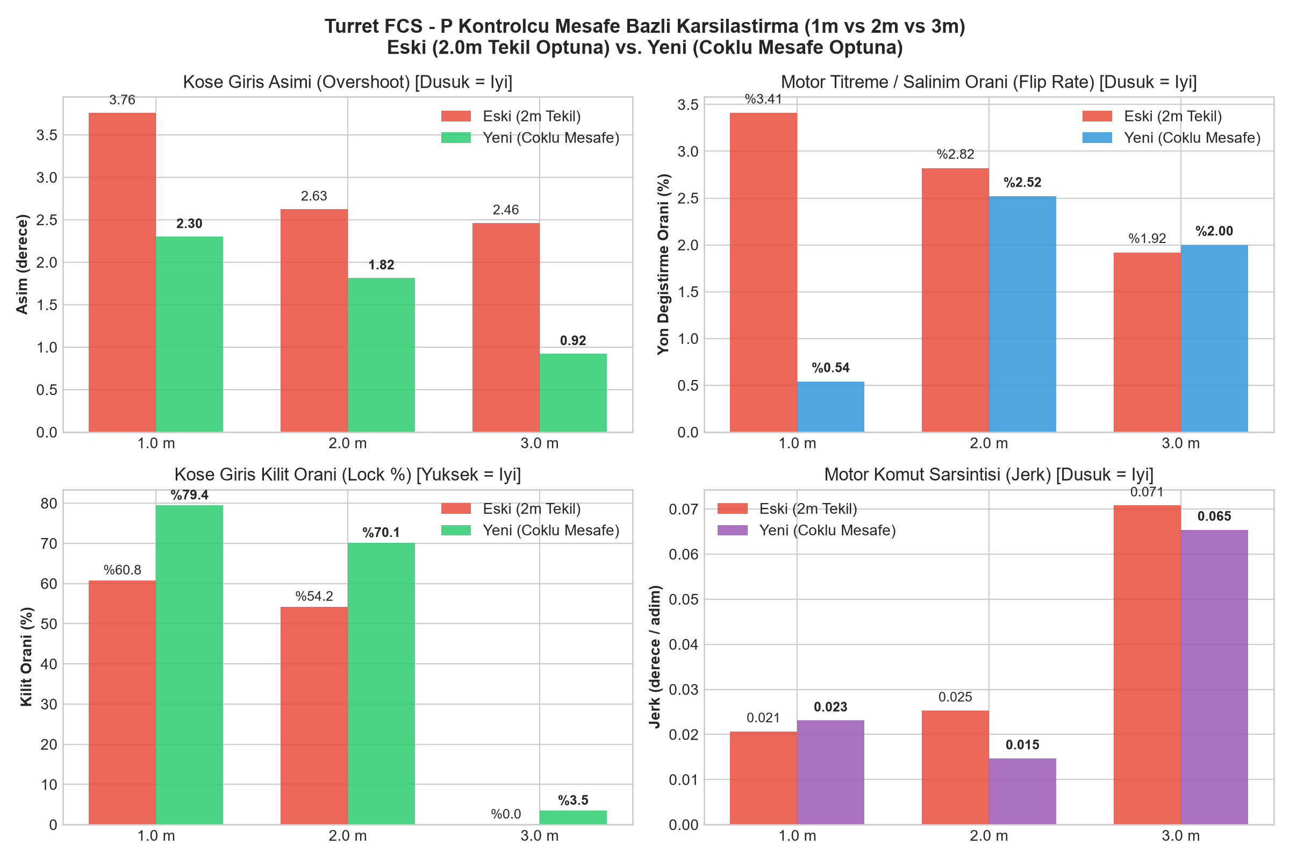
turret_fcs/analysis/comparison/distance_comparison_p.png
