brkaysenturk/turret-fcs/turret_fcs/analysis/comparison/distance_comparison_rl.png

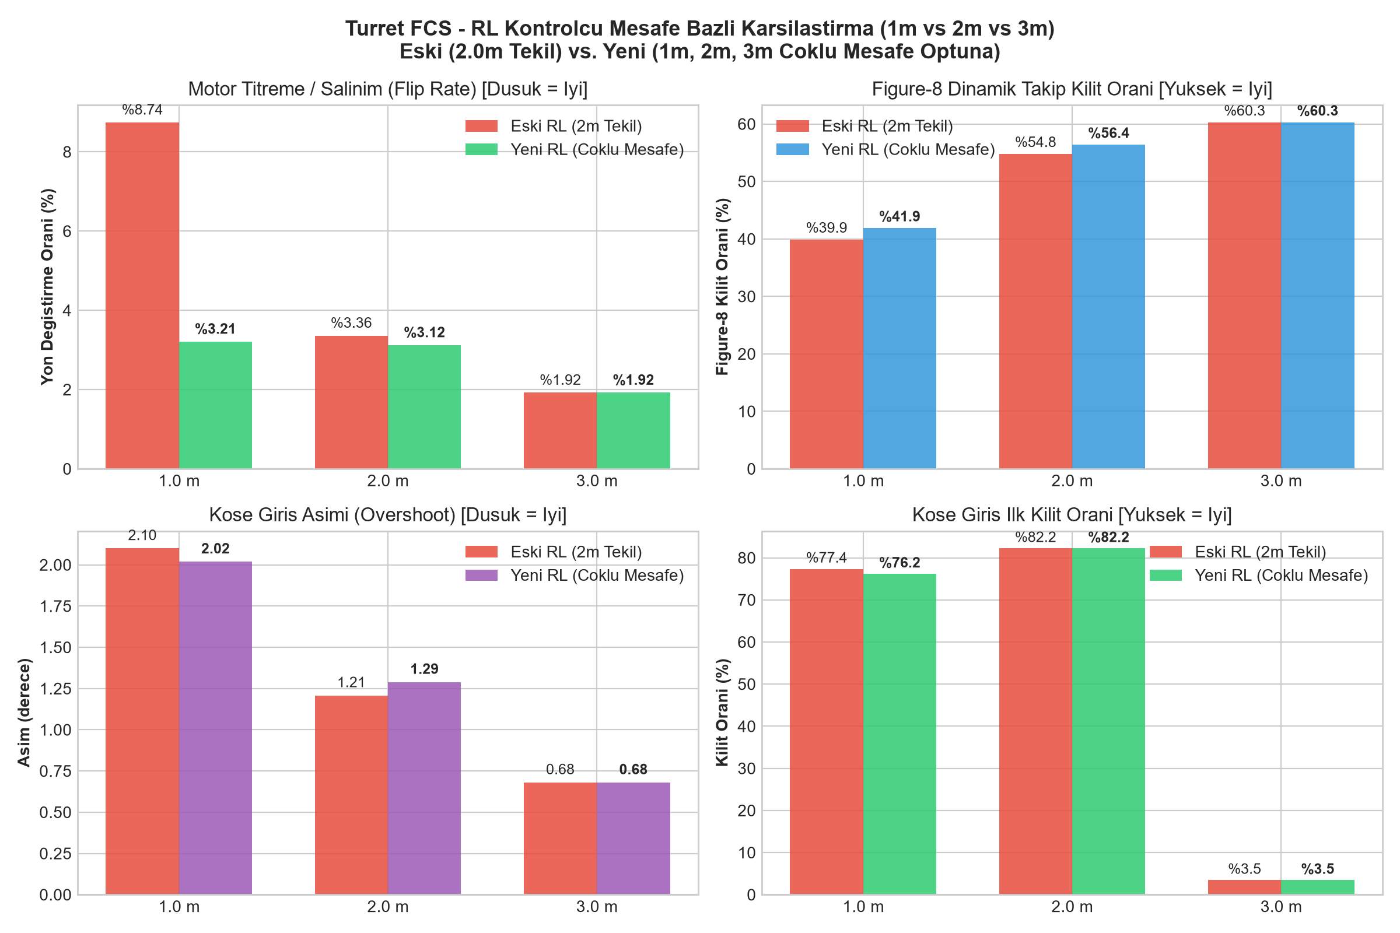
turret_fcs/analysis/comparison/distance_comparison_rl.png
