brkaysenturk/turret-fcs/turret_fcs/analysis/comparison/trial_12_vs_24_rl_comparison.png

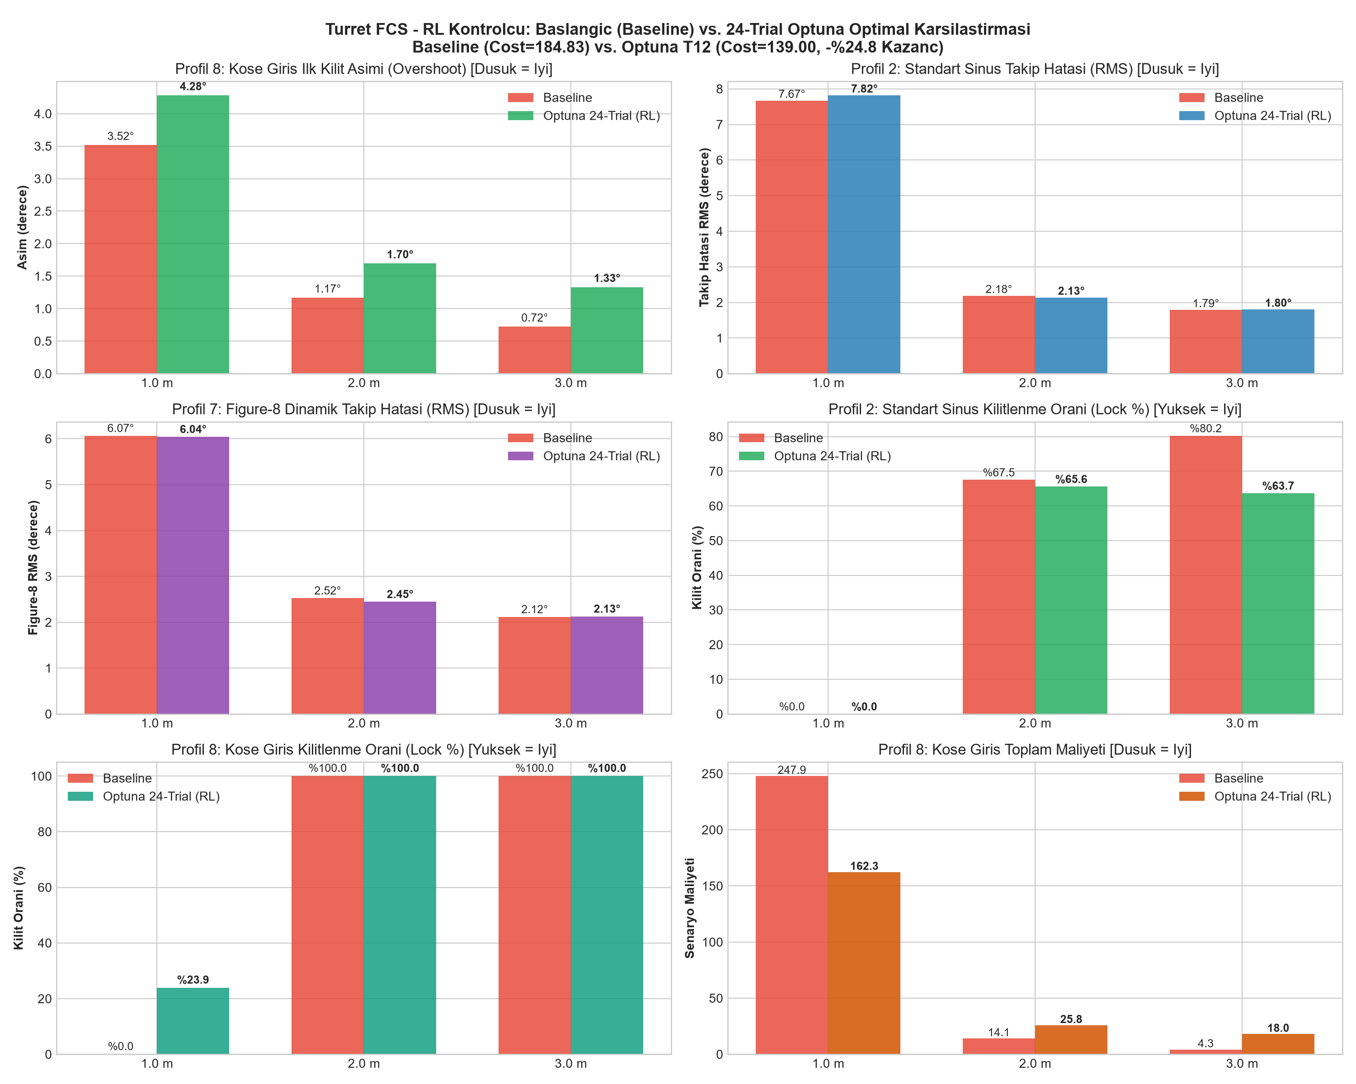
turret_fcs/analysis/comparison/trial_12_vs_24_rl_comparison.png
