brkaysenturk/turret-fcs/turret_fcs/docs/cad/turret_fcs_3d.png

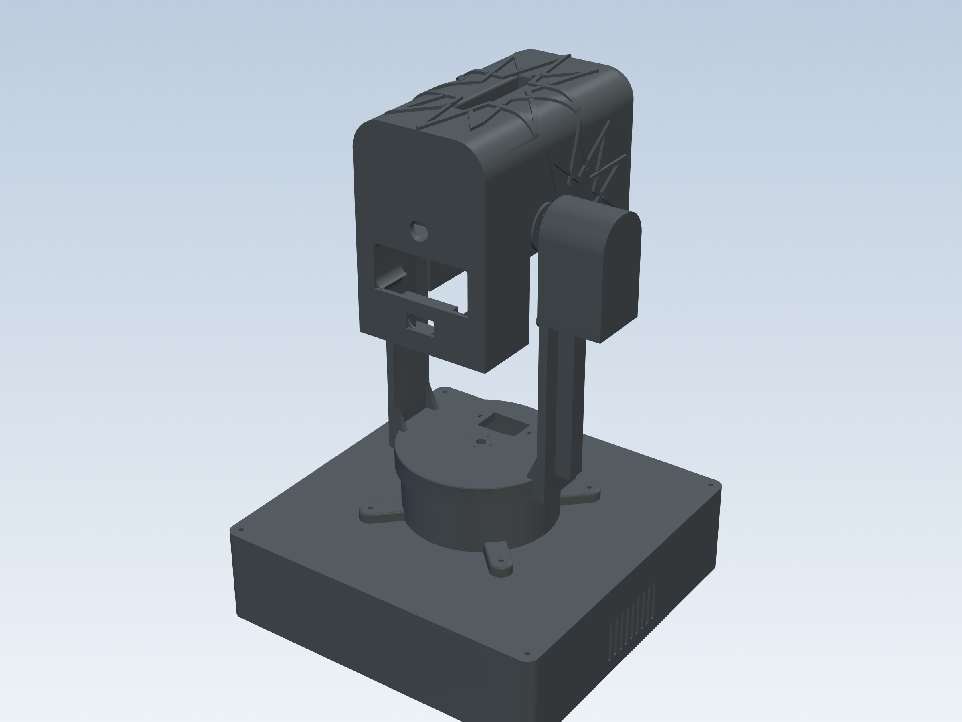
turret_fcs/docs/cad/turret_fcs_3d.png
