brkaysenturk/turret-fcs/turret_fcs/rl_sim/pid_vs_rl_comparison.png

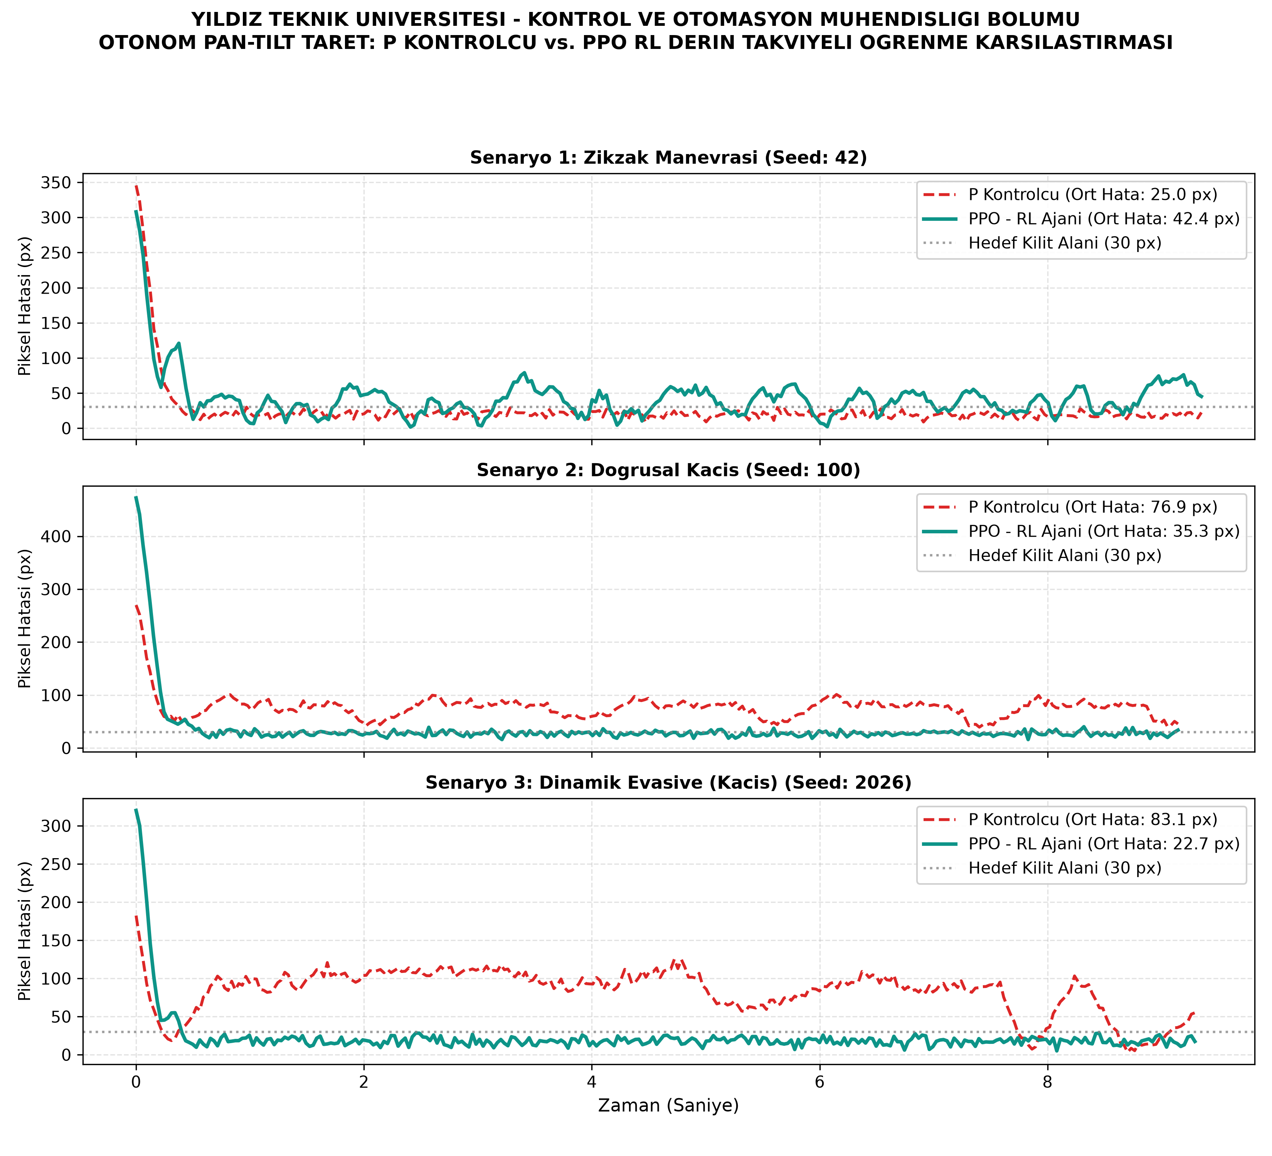
turret_fcs/rl_sim/pid_vs_rl_comparison.png
