brkaysenturk/turret-fcs/webots/worlds/red_ballonn/128.png

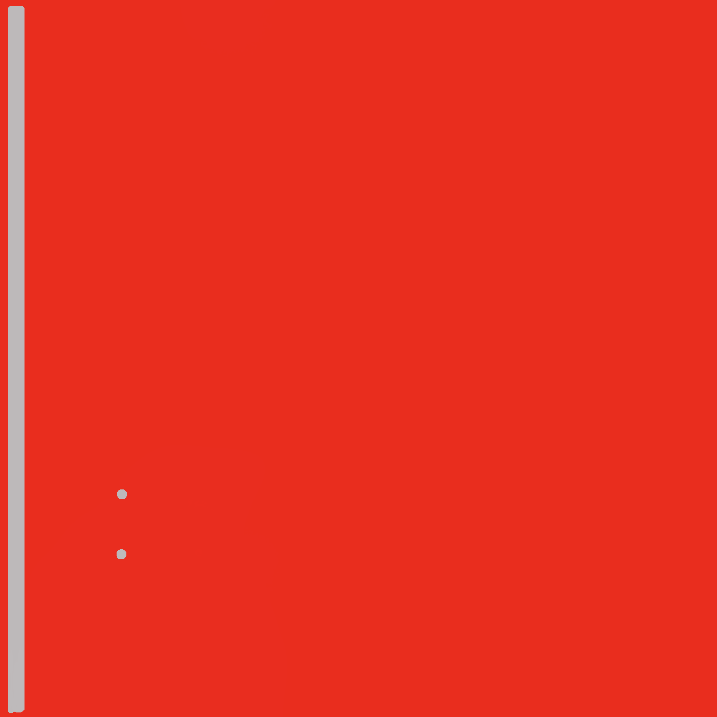
webots/worlds/red_ballonn/128.png
