brkaysenturk/turret-fcs/webots/worlds/red_ballonn/metalnessMap1.png

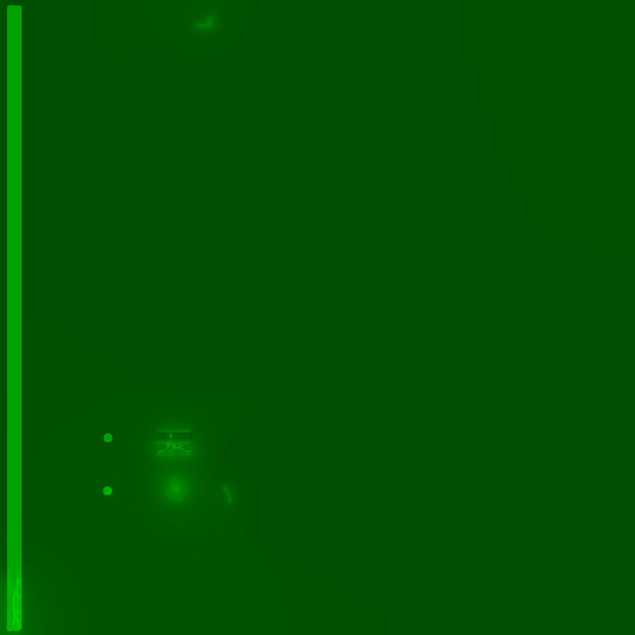
webots/worlds/red_ballonn/metalnessMap1.png
