brkaysenturk/turret-fcs/webots/worlds/tf_luna/Screenshot 2024-02-09 142525.png

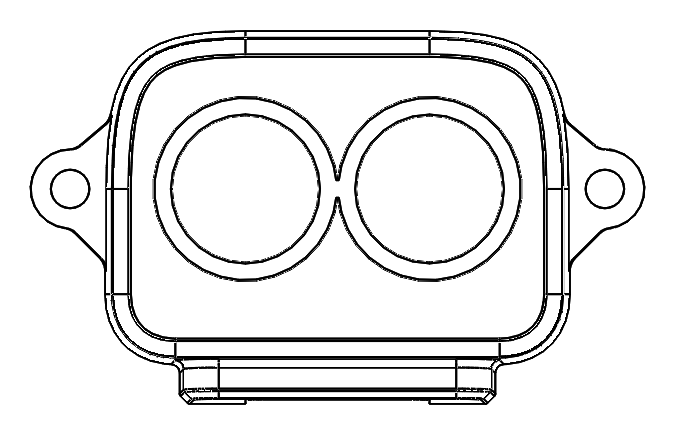
webots/worlds/tf_luna/Screenshot 2024-02-09 142525.png
