brkaysenturk/turret-fcs/webots/worlds/tf_luna/Screenshot 2024-02-09 142606.png

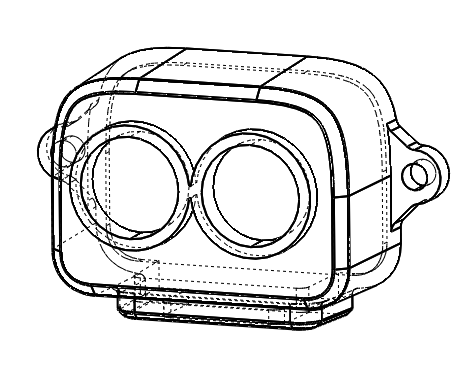
webots/worlds/tf_luna/Screenshot 2024-02-09 142606.png
