brkaysenturk/turret-fcs/webots/worlds/red_ballonn/red ballon.obj

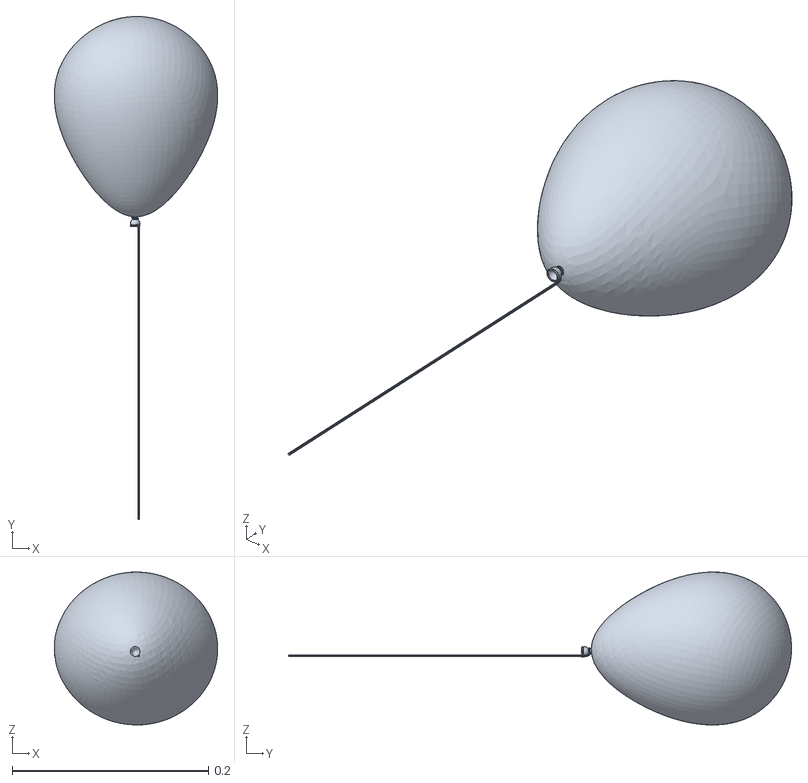
[picture p65: CAD file, 2026-10-05]
webots/worlds/red_ballonn/red ballon.obj
0.166 x 0.512 x 0.156
