brkaysenturk/turret-fcs/turret_basket/analysis/figures/python/python_fig5_cup_tracker_step_response.png

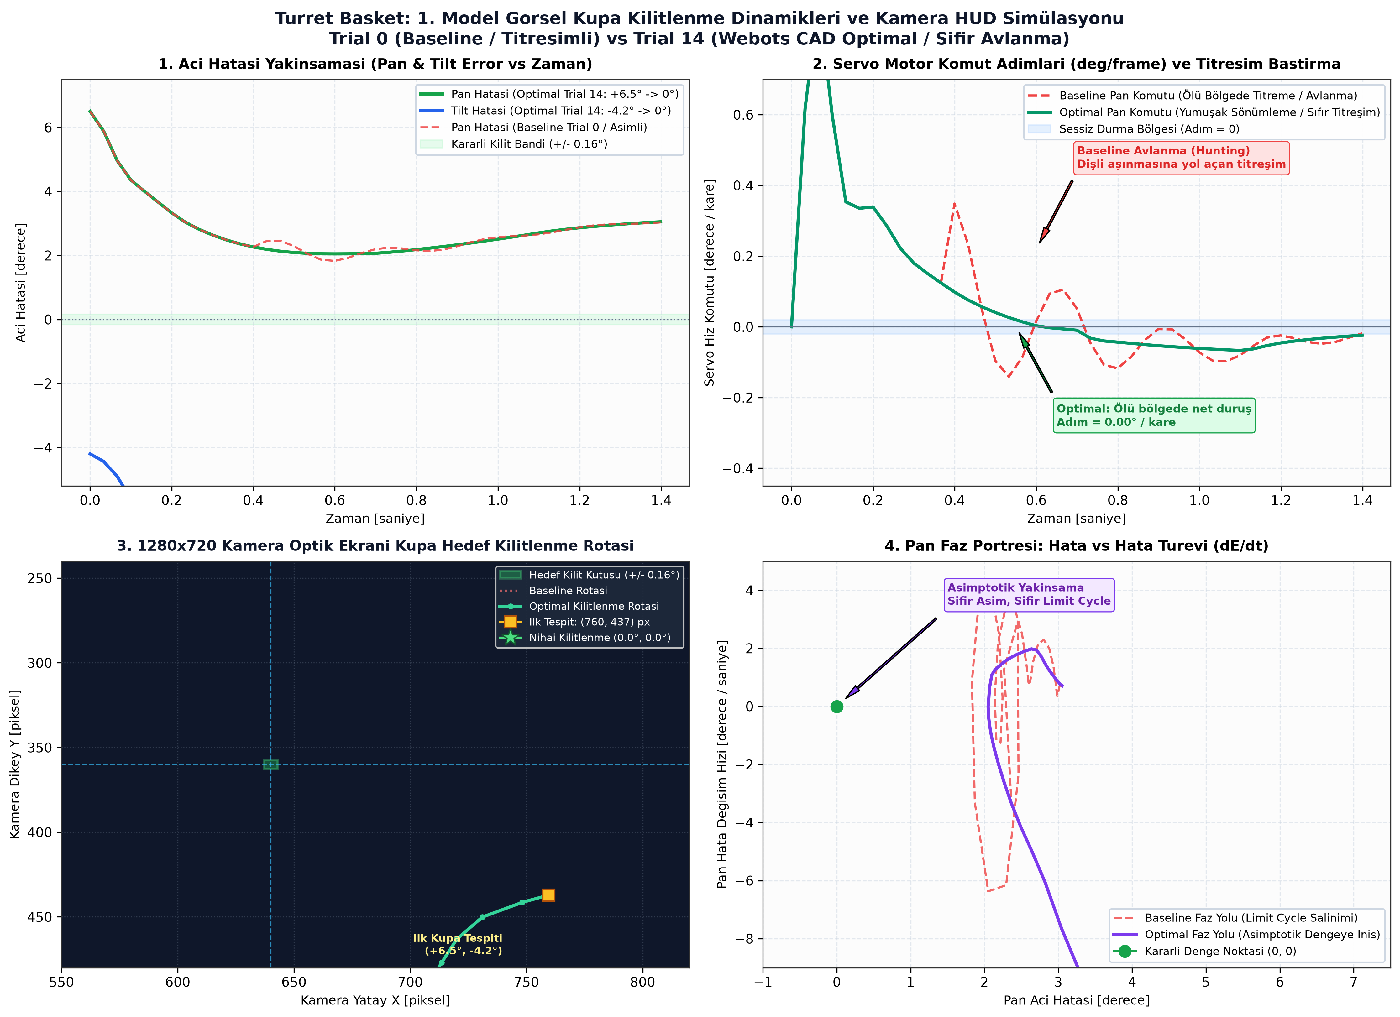
turret_basket/analysis/figures/python/python_fig5_cup_tracker_step_response.png
