brkaysenturk/turret-fcs/docs/evidence/v1.3_benchmark.csv

time_sec | dt | fps | target_detected | box_cx | box_cy | angular_err_pan | angular_err_tilt | cmd_pan | cmd_tilt | target_vel_x | target_vel_y | dist_cm | signal_strength | fcs_state | control_mode | rl_weight | is_locked
0.0 | 0.001 | 999 | 0 | 0 | 0 | 0.0 | 0.0 | 0.0 | 0.0 | 0.0 | 0.0 | 779 | 318 | 0 | PID | 0.0 | 0
0.0579 | 0.3506 | 2 | 0 | 0 | 0 | 0.0 | 0.0 | 0.0 | 0.0 | 0.0 | 0.0 | 778 | 327 | 0 | PID | 0.0 | 0
0.0889 | 0.0334 | 29 | 0 | 0 | 0 | 0.0 | 0.0 | 0.0 | 0.0 | 0.0 | 0.0 | 779 | 318 | 0 | PID | 0.0 | 0
0.1194 | 0.031 | 32 | 0 | 0 | 0 | 0.0 | 0.0 | 0.0 | 0.0 | 0.0 | 0.0 | 779 | 314 | 0 | PID | 0.0 | 0
0.1514 | 0.0305 | 32 | 0 | 0 | 0 | 0.0 | 0.0 | 0.0 | 0.0 | 0.0 | 0.0 | 776 | 316 | 0 | PID | 0.0 | 0
0.1834 | 0.033 | 30 | 0 | 0 | 0 | 0.0 | 0.0 | 0.0 | 0.0 | 0.0 | 0.0 | 777 | 324 | 0 | PID | 0.0 | 0
0.2159 | 0.032 | 31 | 0 | 0 | 0 | 0.0 | 0.0 | 0.0 | 0.0 | 0.0 | 0.0 | 775 | 316 | 0 | PID | 0.0 | 0
0.2499 | 0.0335 | 29 | 0 | 0 | 0 | 0.0 | 0.0 | 0.0 | 0.0 | 0.0 | 0.0 | 776 | 321 | 0 | PID | 0.0 | 0
0.2846 | 0.033 | 30 | 0 | 0 | 0 | 0.0 | 0.0 | 0.0 | 0.0 | 0.0 | 0.0 | 778 | 319 | 0 | PID | 0.0 | 0
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
