brkaysenturk/turret-fcs/analysis/comparison/all_profiles_benchmark.csv

Mode | Version | Profile | Cost | Tail_RMS_deg | Lock_Pct | Flip_Pct | Overshoot_deg | Duration_s
P | Baseline | 0 | -25.89 | 1.848 | 92.53 | 0.0 | 0.0 | 10.9
P | Baseline | 1 | 10.267 | 2.437 | 52.0 | 1.0 | 0.0 | 11.2
P | Baseline | 2 | 33.079 | 2.918 | 26.13 | 0.75 | 0.0 | 10.4
P | Baseline | 3 | 56.48 | 3.743 | 10.4 | 0.98 | 0.0 | 9.9
P | Baseline | 4 | 78.171 | 6.758 | 56.0 | 1.32 | 0.0 | 10.0
P | Baseline | 5 | 60.023 | 3.827 | 6.4 | 0.95 | 0.0 | 10.3
P | Baseline | 7 | 54.424 | 3.46 | 6.13 | 1.01 | 0.0 | 10.5
P | Baseline | 8 | 105.509 | 2.599 | 52.2 | 2.72 | 2.638 | 10.6
P | Optuna | 0 | -24.878 | 1.91 | 92.53 | 0.0 | 0.0 | 11.2
P | Optuna | 1 | 12.724 | 2.453 | 48.0 | 0.91 | 0.0 | 12.3
P | Optuna | 2 | 33.792 | 2.969 | 26.13 | 0.72 | 0.0 | 12.9
P | Optuna | 3 | 59.099 | 3.903 | 10.13 | 0.98 | 0.0 | 12.8
P | Optuna | 4 | 81.458 | 6.826 | 51.73 | 1.17 | 0.0 | 10.9
P | Optuna | 5 | 61.715 | 3.86 | 4.27 | 0.91 | 0.0 | 9.9
P | Optuna | 7 | 56.632 | 3.574 | 5.33 | 0.99 | 0.0 | 9.9
P | Optuna | 8 | 86.47 | 2.523 | 58.24 | 0.69 | 2.233 | 9.9
RL | Baseline | 0 | -14.976 | 1.815 | 92.8 | 5.26 | 0.0 | 10.7
RL | Baseline | 1 | 0.707 | 2.266 | 62.93 | 0.81 | 0.0 | 10.8
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
