brkaysenturk/turret-fcs/analysis/figures/fig11_p_vs_rl_final_benchmark.png

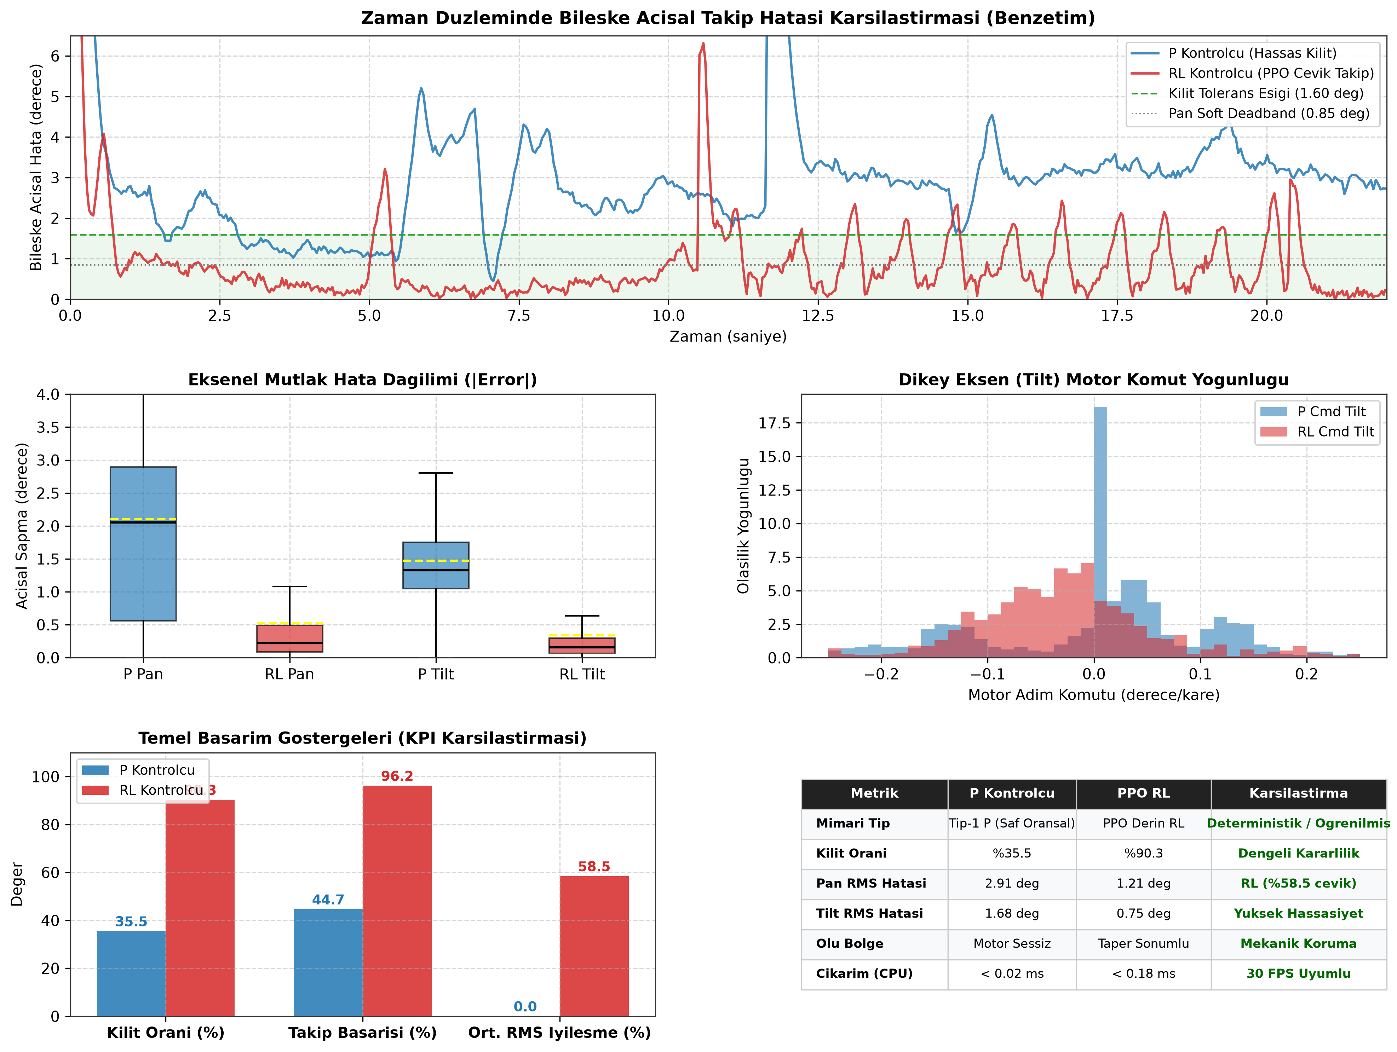
analysis/figures/fig11_p_vs_rl_final_benchmark.png
