brkaysenturk/turret-fcs/analysis/figures/matlab/matlab_fig6_hil_test_result.png

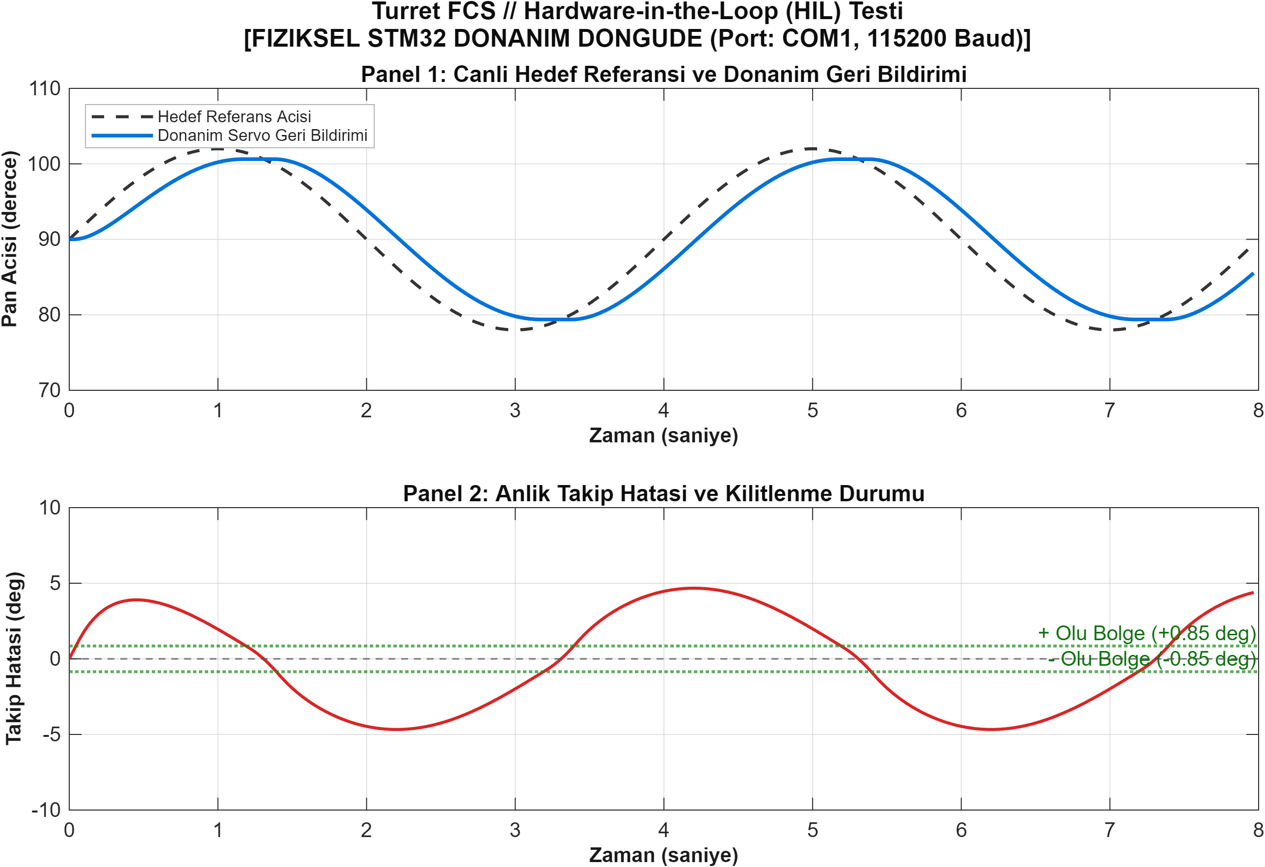
analysis/figures/matlab/matlab_fig6_hil_test_result.png
