brkaysenturk/turret-fcs/analysis/figures/oct12_field_tests_analysis.png

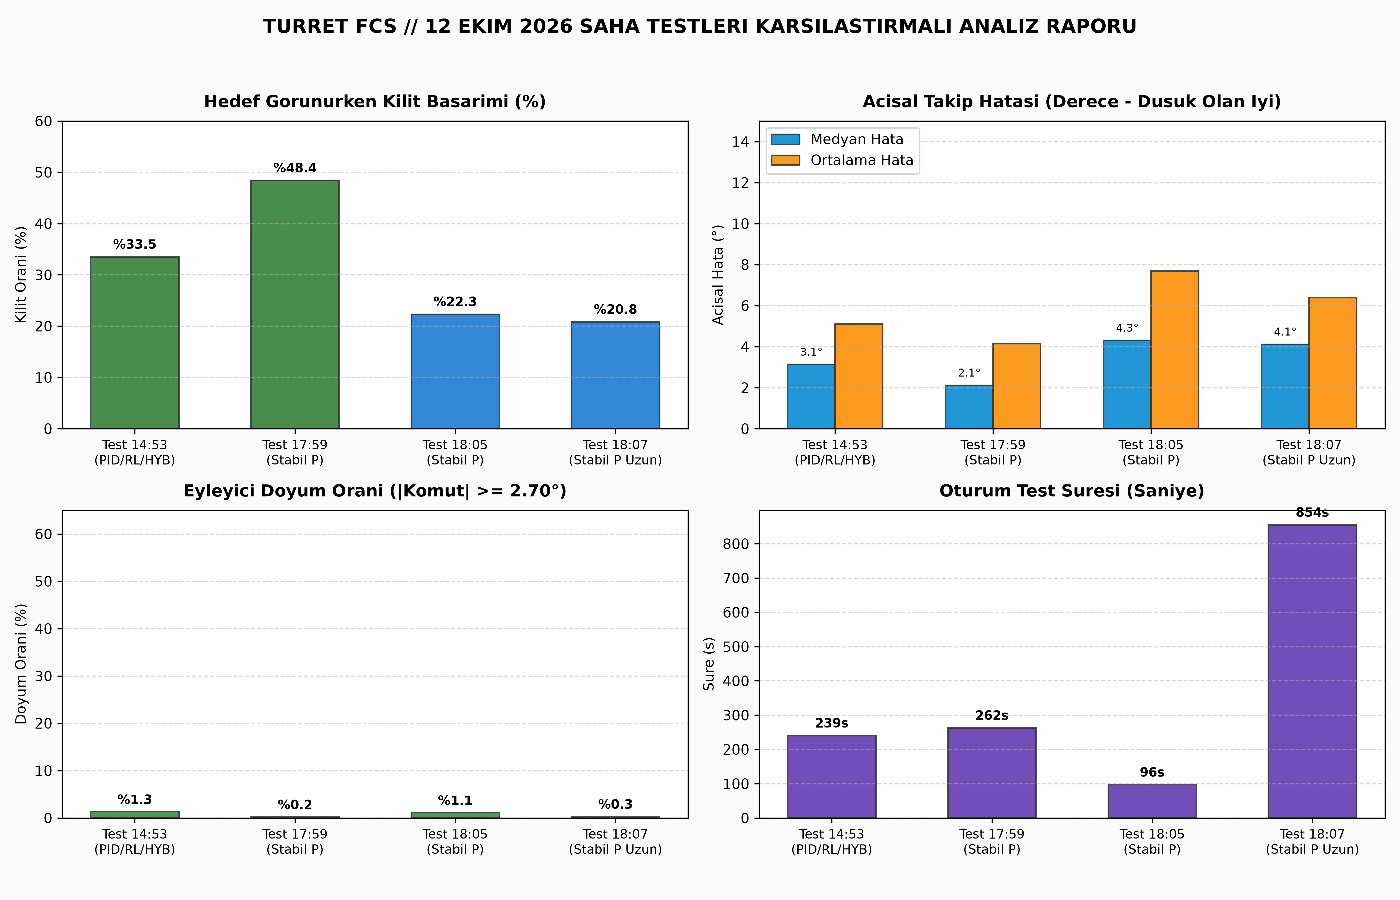
analysis/figures/oct12_field_tests_analysis.png
