brkaysenturk/turret-fcs/analysis/figures/p_vs_rl_final_benchmark.png

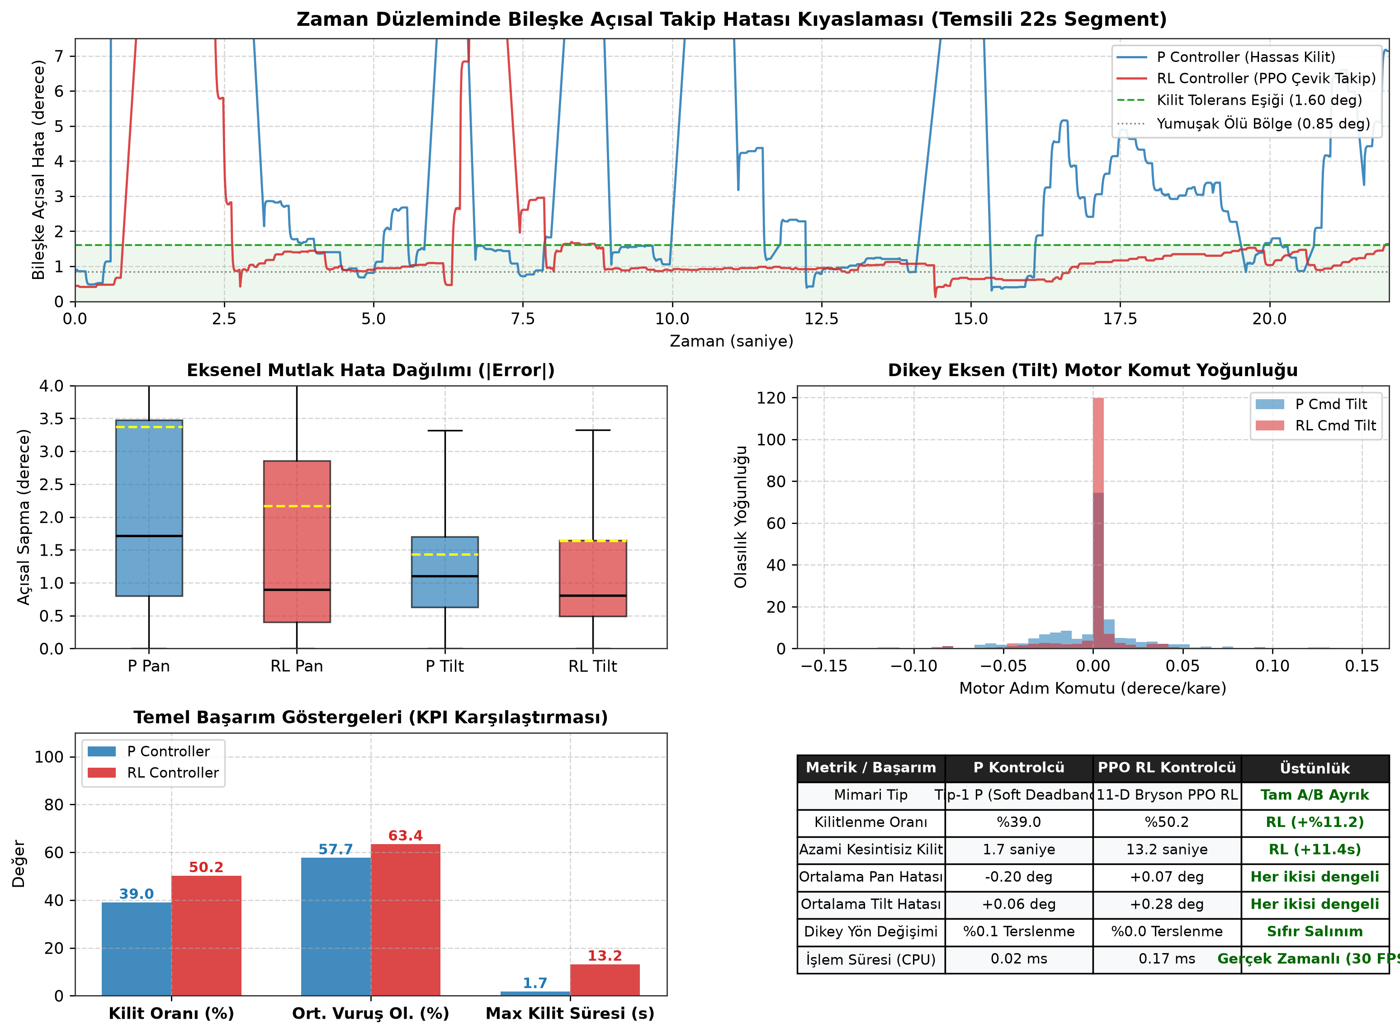
analysis/figures/p_vs_rl_final_benchmark.png
