brkaysenturk/turret-fcs/analysis/figures/python/python_fig11_p_vs_rl_final_benchmark.png

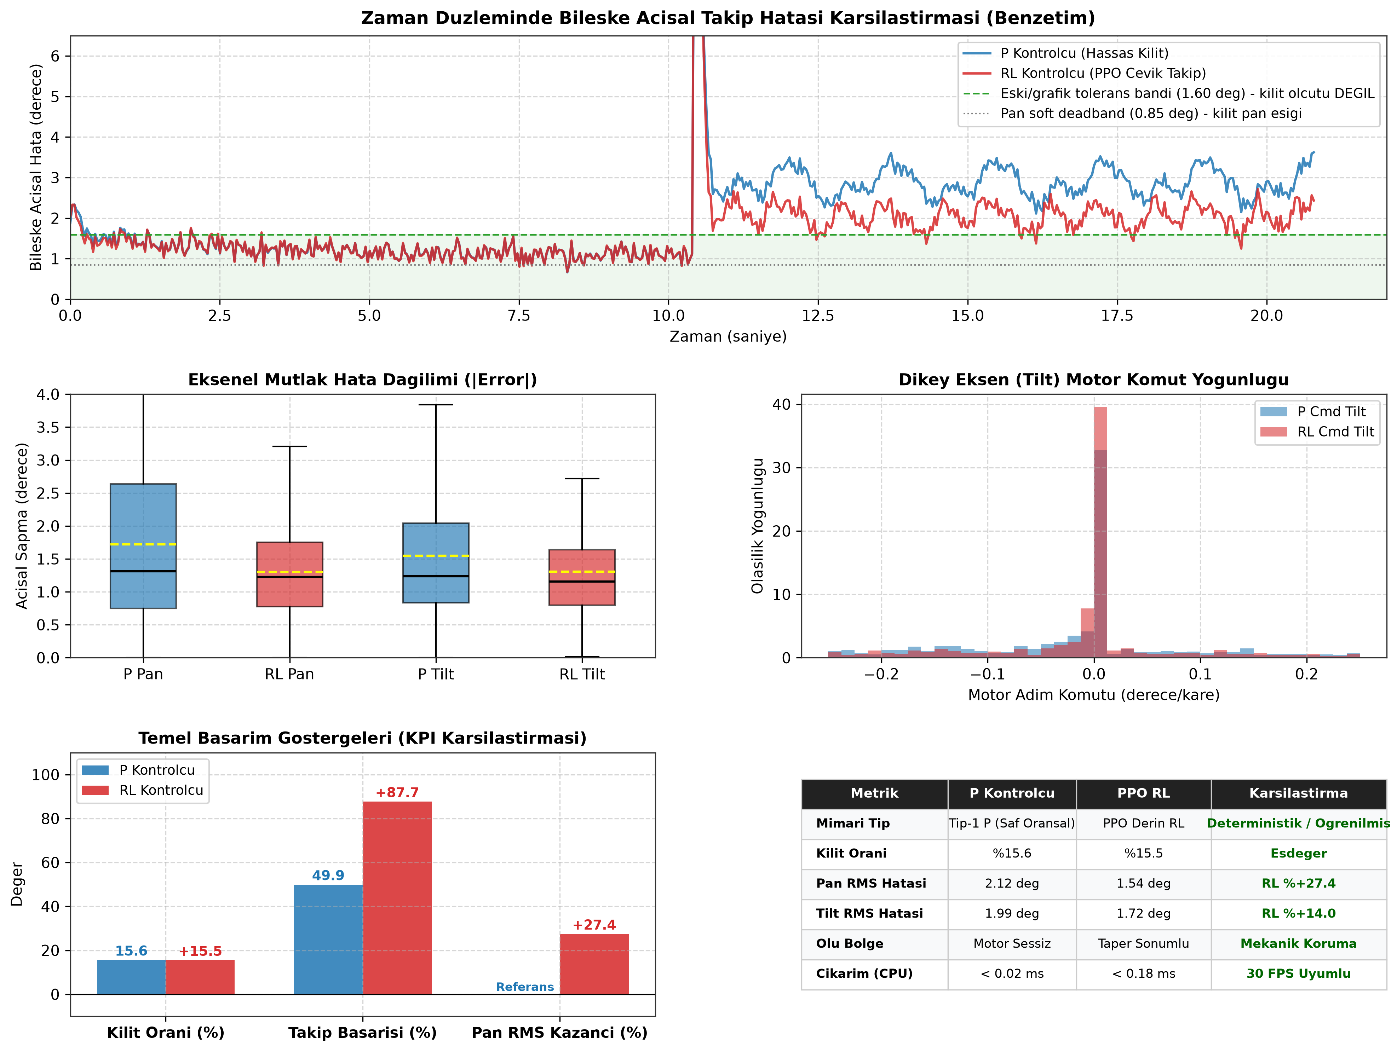
analysis/figures/python/python_fig11_p_vs_rl_final_benchmark.png
