brkaysenturk/turret-fcs/turret_basket/stm32/Core/Src/main.c

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

/* Includes ------------------------------------------------------------------*/
#include "main.h"

/* USER CODE BEGIN Includes */
#include "protocol.h"
#include "luna_read.h"
#include "servo_driver.h"
#include "basket_comm.h"
#include "flywheel_solenoid.h"
/* USER CODE END Includes */

/* USER CODE BEGIN PD */
/*
 * Fiziksel ates yolu guvenlik ve etik tedbir nedeniyle varsayilan olarak KAPALI (0).
 * Gercek dart atis testinde 1 yapilabilir.
 */
#ifndef ENABLE_PHYSICAL_FIRE
#define ENABLE_PHYSICAL_FIRE 0
#endif

/*
 * Zaman Asimlari (ms)
 * - 300 ms: PC komut akisi kesilirse firlatici durdurulur (fail-safe).
 * - 2000 ms: PC kalici olarak kesilirse servolar stall isinmasini onlemek
 *            icin yumusakca mekanik merkeze (90.0, 90.0) park edilir.
 */
#define BASKET_CMD_TIMEOUT_MS   300u
#define SERVO_PARK_TIMEOUT_MS  2000u

/*
 * Bagimsiz Bekci Kopegi (IWDG)
 * LSI ~32 kHz, bolucu /64 -> 500 Hz (2 ms/sayac), reload 400 -> 800 ms pencere.
 */
#define IWDG_PRESCALER         IWDG_PRESCALER_64
#define IWDG_RELOAD_COUNTS     400u
/* USER CODE END PD */

UART_HandleTypeDef huart1;
UART_HandleTypeDef huart2;
IWDG_HandleTypeDef hiwdg;

/* USER CODE BEGIN PV */
/*
 * B1 Mavi Buton (PC13 / EXTI13) Mandalli Yazilim E-Stop:
 * Her basista mandal terslenir. Mandal aktifken PC komutlari yok sayilir,
 * launcher aninda kesilir ve servolar hiz sinirli olarak merkeze iner.
 */
static volatile bool b1_estop_latched = false;
static volatile bool b1_press_event = false;
static uint32_t b1_last_edge_ms = 0;
/* USER CODE END PV */

void SystemClock_Config(void);
static void MX_GPIO_Init(void);
static void MX_USART1_UART_Init(void);
static void MX_USART2_UART_Init(void);
static void MX_IWDG_Init(void);

/**
  * @brief  Uygulama ana giris noktasi (Application entry point).
  */
int main(void)
{
  /* MCU Configuration --------------------------------------------------------*/
  HAL_Init();

  /* USER CODE BEGIN Init */
  /* Watchdog'u olasi erken kilitlenmelere karsi en basta baslat */
  MX_IWDG_Init();
  /* USER CODE END Init */

  SystemClock_Config();

  MX_GPIO_Init();
  MX_USART1_UART_Init();
  MX_USART2_UART_Init();

  /* USER CODE BEGIN 2 */
  /* Donanim Modullerini Baslat */
  Luna_Init(&huart1);
  Basket_Comm_Init(&huart2);
  Servo_Init();
  Launcher_Init(); /* Pinleri guvenli PULLDOWN ve 0V durumuna kilitler */

  uint32_t last_pc_cmd_time = HAL_GetTick();
  bool servos_park = false;
#if ENABLE_PHYSICAL_FIRE
  static uint8_t prev_cmd_state = PROTO_STATE_TRACKING;
#endif
  uint32_t last_led_time = 0;
  /* USER CODE END 2 */

  /* Infinite loop */
  /* USER CODE BEGIN WHILE */
  while (1)
  {
    /* USER CODE END WHILE */

    /* USER CODE BEGIN 3 */
    /* 0. Watchdog beslemesi */
    HAL_IWDG_Refresh(&hiwdg);

    /* 1. Sabit ~100 Hz Periyodik Telemetri Gonderimi (LiDAR + Servo Aci Geri Bildirimi) */
    uint16_t dist = Luna_GetDistance();
    uint16_t strength = Luna_GetStrength();
    Basket_Comm_SendTelemetry(dist, strength, Servo_GetPan(), Servo_GetTilt());

    /* 2. B1 Mavi Buton E-stop Mandali */
    if (b1_press_event)
    {
      b1_press_event = false;
      b1_estop_latched = !b1_estop_latched;
      if (b1_estop_latched)
      {
        Launcher_EmergencyStop();
        servos_park = true;
#if ENABLE_PHYSICAL_FIRE
        prev_cmd_state = PROTO_STATE_TRACKING;
#endif
      }
      else
      {
        servos_park = false;
      }
    }

    if (b1_estop_latched)
    {
      Launcher_EmergencyStop();
      servos_park = true;
    }

    /* 3. PC'den yeni komut alimi ve motor kontrolu */
    float d_pan = 0.0f;
    float d_tilt = 0.0f;
    uint8_t speed_pwm = 0;
    uint8_t state = 0;
    if (!b1_estop_latched && Basket_Comm_GetCommand(&d_pan, &d_tilt, &speed_pwm, &state))
    {
      last_pc_cmd_time = HAL_GetTick();

      if (state == PROTO_STATE_ESTOP)
      {
        Launcher_EmergencyStop();
        servos_park = true;
#if ENABLE_PHYSICAL_FIRE
        prev_cmd_state = PROTO_STATE_TRACKING;
#endif
      }
      else
      {
        servos_park = false;
        Servo_ApplyCorrection(d_pan, d_tilt);

#if ENABLE_PHYSICAL_FIRE
        /* Ates tetigi: Volan hazirsa ve yukselen kenar (FIRING) gelmisse */
        if (state == PROTO_STATE_FIRING && prev_cmd_state != PROTO_STATE_FIRING)
        {
          (void)Launcher_TriggerFire();
        }
#endif

        /* TB6612FNG Dinamik Volan Hizi Kontrolu:
         * LOCKED (1) veya FIRING (2) durumunda gelen speed_pwm degerine gore devir ayarla.
         * TRACKING (0) veya ESTOP durumunda motoru durdur. */
        if (state == PROTO_STATE_LOCKED || state == PROTO_STATE_FIRING)
        {
          uint8_t target_spd = (speed_pwm > 0) ? speed_pwm : 190u;
          Launcher_Flywheel_SetSpeed(target_spd);
        }
        else
        {
          if (!Launcher_IsFiring())
          {
            Launcher_Flywheel_SetSpeed(0u);
          }
        }
      }

#if ENABLE_PHYSICAL_FIRE
      prev_cmd_state = (state == PROTO_STATE_ESTOP) ? PROTO_STATE_TRACKING : state;
#endif
    }

    /* 4. Heartbeat Watchdog: PC akisi 300 ms kesilirse firlatici kapatilir */
    if (HAL_GetTick() - last_pc_cmd_time > BASKET_CMD_TIMEOUT_MS)
    {
      Launcher_EmergencyStop();
#if ENABLE_PHYSICAL_FIRE
      prev_cmd_state = PROTO_STATE_TRACKING;
#endif
    }

    /* 5. Uzun sureli iletisim kaybinda servolari merkeze al */
    if (HAL_GetTick() - last_pc_cmd_time > SERVO_PARK_TIMEOUT_MS)
    {
      servos_park = true;
    }

    /* 6. Yumusak merkezleme (Hiz sinirli ve sarsintisiz) */
    if (servos_park)
    {
      (void)Servo_HomeStep();
    }

    /* 7. Durum LED'i (LD2 / PA5) 500 ms kalp atisi */
    if (HAL_GetTick() - last_led_time >= 500)
    {
      last_led_time = HAL_GetTick();
      HAL_GPIO_TogglePin(LD2_GPIO_Port, LD2_Pin);
    }

    /* 8. Firlatici durum makinesi (non-blocking) */
    Launcher_Update();

    HAL_Delay(10); /* ~100 Hz dongu periyodu */
  }
  /* USER CODE END 3 */
}

/* USER CODE BEGIN 4 */
/**
  * @brief UART Kesme Callback (Tum alimlar modullere yonlendirilir)
  */
void HAL_UART_RxCpltCallback(UART_HandleTypeDef *huart)
{
  if (huart->Instance == USART1)
  {
    Luna_RxCallback(huart);
  }
  else if (huart->Instance == USART2)
  {
    Basket_Comm_RxCallback(huart);
  }
}

/**
  * @brief UART Hata Callback
  */
void HAL_UART_ErrorCallback(UART_HandleTypeDef *huart)
{
  if (huart->Instance == USART1)
  {
    Luna_HandleError();
  }
  else if (huart->Instance == USART2)
  {
    Basket_Comm_HandleError();
  }
}

/**
  * @brief EXTI Callback (B1 Mavi Buton)
  */
void HAL_GPIO_EXTI_Callback(uint16_t GPIO_Pin)
{
  if (GPIO_Pin == B1_Pin)
  {
    uint32_t now = HAL_GetTick();
    if (b1_last_edge_ms == 0u || (now - b1_last_edge_ms) >= 250u)
    {
      b1_last_edge_ms = now;
      b1_press_event = true;
    }
  }
}
/* USER CODE END 4 */

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
