brkaysenturk/turret-fcs/webots/controllers/webots_turret_fcs/webots_virtual_ballistics.py

"""
================================================================================
MODUL: WEBOTS SANAL BALISTIK VE 3D ISABET HAKEMI (VIRTUAL BALLISTICS - v2.0)
================================================================================
Bu modul; Webots icerisinde atis gerceklestiginde namlu rotasyon matrisinden
(KAFA_BLOGU orientation) dogrudan 3B namlu dogrultu vektorunu alarak yercekimi
dususu ve mermi ucus suresiyle hedef balon uzerindeki 3B carpisma noktasini (X, Y, Z)
analitik ve fiziksel olarak hesaplayan hakem sinifidir.

v2.0 UYUMLULUKLARI:
- Koordinat Dogrulugu: KAFA_BLOGU 3B oryantasyon vektoru [fx, fy, fz] uzerinden
  hesaplanan dunya carpisma koordinati; eksen isareti veya tanjant sapmasi icermez.
- Zaman Tabani: Saf simulasyon zamani (sim_t), sifir wall-clock kaymasi.
- Gosterim Suresi: 1.50 saniye (BALLISTIC_DISPLAY_DURATION ile tam senkron).
- Hedef Geometrisi: 3D balon merkezi ve 0.15 m yaricap toleransi.
================================================================================
"""

import math

from turret_fcs.config import CONFIG
from turret_fcs.ballistics import compute_rk4_drop


class VirtualBallisticsEvaluator:
    """
    Sanal Mermi Ucus ve Canli 3D Carpisma Hakemi.
    Atis tetiklendiginde balistik ucusu takip eder, hedefe vardigi anda
    gercek balon 3D koordinatiyla kiyaslayip isabeti tesciller.
    """

    def __init__(self, bullet_speed=None, target_radius_m=None, supervisor=None):
        self.bullet_speed = float(bullet_speed) if bullet_speed else CONFIG.ballistics.projectile_speed_mps
        self.target_radius_m = float(target_radius_m) if target_radius_m else CONFIG.lock.target_radius_m
        self.supervisor = supervisor

        # Balon ve Kafa blogu dugum baglantilari
        self.balloon_node = None
        self.kafa_node = None
        if self.supervisor is not None:
            try:
                self.balloon_node = self.supervisor.getFromDef("BALLOON")
                self.kafa_node = self.supervisor.getFromDef("KAFA_BLOGU")
            except Exception:
                pass

        self.active_shots = []

        # Son atis sonucu
        self.last_result_text = ""
        self.last_result_color = (0, 255, 0)
        self.last_result_sim_time = -999.0
        self.DISPLAY_DURATION = CONFIG.ballistics.eval_display_time_s

        self.total_shots = 0
        self.total_hits = 0

        # Son atis telemetrisi (A/D): merkez mesafesi ve isabet/iska metrikleri
        self.last_hit = None          # None: beklemede, True: isabet, False: iska
        self.last_miss_cm = None
        self.last_shot = None

    def get_hud_result(self, sim_time):
        """HUD gosterimi icin son isabet sonucunu doner (sim_t zaman tabanli)."""
        if (sim_time - self.last_result_sim_time) < self.DISPLAY_DURATION and self.last_result_text:
            return self.last_result_text, self.last_result_color
        return None, None

    def fire_shot(self, dist_m=2.0, sim_time=0.0):
        """
        Atis aninda KAFA_BLOGU 3B oryantasyonundan namlu ileri vektorunu alir.
        LiDAR on yuzey mesafesini olcer; hedef merkezine gitmek icin yaricap eklenir.
        """
        dist_front = max(0.5, float(dist_m)) if dist_m else CONFIG.ballistics.default_distance_m
        # LiDAR ön yüzeyi ölçer; balistik merkez için +hedef yarıçapı
        dist = dist_front + self.target_radius_m
        if CONFIG.ballistics.drag_enabled:
            gravity_drop_m, t_flight = compute_rk4_drop(
                dist,
                v0=self.bullet_speed,
                g=CONFIG.ballistics.gravity_accel,
                k=CONFIG.ballistics.drag_k,
            )
        else:
            t_flight = dist / self.bullet_speed
            g = CONFIG.ballistics.gravity_accel
            gravity_drop_m = 0.5 * g * (t_flight ** 2)
        t_delay = CONFIG.ballistics.system_latency_s  # CONFIG SSOT donanim tasiyici gecikmesi

        # Namlu merkez konumu ve 3B donus matrisi
        head_pos = self.kafa_node.getPosition() if self.kafa_node else [0.0, 0.0, 1.0131]
        head_rot = self.kafa_node.getOrientation() if self.kafa_node else [1, 0, 0, 0, 1, 0, 0, 0, 1]

        # Webots kafa blogunda yerel Y ekseni namlunun ileri dogrultusudur
        fx_dir = head_rot[1]
        fy_dir = head_rot[4]
        fz_dir = head_rot[7]

        # Namlu cikis konumu (CAD v10: Namlu ucu +0.075 m onde, kafa Z ekseninde +0.0256 m yukarida)
        muzzle_x = head_pos[0] + head_rot[1] * 0.075 + head_rot[2] * 0.0256
        muzzle_y = head_pos[1] + head_rot[4] * 0.075 + head_rot[5] * 0.0256
        muzzle_z = head_pos[2] + head_rot[7] * 0.075 + head_rot[8] * 0.0256

        # 3B dunya carpisma koordinati (merkez mesafesiyle)
        impact_x = muzzle_x + fx_dir * dist
        impact_y = muzzle_y + fy_dir * dist
        impact_z = muzzle_z + fz_dir * dist - gravity_drop_m

        shot = {
            "fire_sim_time": sim_time,
            "impact_sim_time": sim_time + t_flight + t_delay,
            "flight_time_s": t_flight + t_delay,
            "impact_x": impact_x,
            "impact_y": impact_y,
            "impact_z": impact_z,
            "muzzle_x": muzzle_x,
            "muzzle_y": muzzle_y,
            "muzzle_z": muzzle_z,
            "fx_dir": fx_dir,
            "fy_dir": fy_dir,
            "fz_dir": fz_dir,
            "dist_front_m": dist_front,
            "dist_center_m": dist,
            "gravity_drop_cm": gravity_drop_m * 100.0,
        }
        self.active_shots.append(shot)
        self.total_shots += 1
        self.last_shot = shot
        self.last_hit = None
        self.last_miss_cm = None

    def update(self, sim_time):
        """Ucus suresi dolan mermileri balon konumuyla karsilastirir ve hakem kararini uretir."""
        remaining_shots = []

        for shot in self.active_shots:
            if sim_time >= shot["impact_sim_time"]:
                # Carpisma aninda gercek balon konumunu al
                b_pos = self._get_balloon_position()
                if b_pos:
                    # Merminin hedef Y derinligindeki gercek 3D carpisma noktasi (Enine Isabet Analizi)
                    fy = shot.get("fy_dir", 1.0)
                    muzzle_y = shot.get("muzzle_y", 0.0)
                    muzzle_x = shot.get("muzzle_x", 0.0)
                    muzzle_z = shot.get("muzzle_z", 1.05)
                    fx = shot.get("fx_dir", 0.0)
                    fz = shot.get("fz_dir", 0.0)

                    if abs(fy) > 1e-4:
                        dist_to_plane = max(0.5, (b_pos[1] - muzzle_y) / fy)
                    else:
                        dist_to_plane = shot["dist_center_m"]

                    if CONFIG.ballistics.drag_enabled:
                        drop_m, _ = compute_rk4_drop(
                            dist_to_plane,
                            v0=self.bullet_speed,
                            g=CONFIG.ballistics.gravity_accel,
                            k=CONFIG.ballistics.drag_k,
                        )
                    else:
                        t_fl = dist_to_plane / self.bullet_speed
                        drop_m = 0.5 * CONFIG.ballistics.gravity_accel * (t_fl ** 2)

                    impact_x = muzzle_x + fx * dist_to_plane
                    impact_y = b_pos[1]
                    impact_z = muzzle_z + fz * dist_to_plane - drop_m

                    shot["impact_x"] = impact_x
                    shot["impact_y"] = impact_y
                    shot["impact_z"] = impact_z

                    dx = impact_x - b_pos[0]
                    dz = impact_z - b_pos[2]
                    err_transverse = math.sqrt(dx * dx + dz * dz)

                    is_hit = err_transverse <= self.target_radius_m
                    self.last_hit = bool(is_hit)
                    self.last_miss_cm = float(err_transverse * 100.0)
                    if is_hit:
                        self.total_hits += 1
                        if err_transverse <= 0.05:
                            self.last_result_text = f"BULLSEYE! (ERR: {err_transverse*100.0:.1f}cm)"
                            self.last_result_color = (0, 255, 0)
                        else:
                            self.last_result_text = f"HIT! (ERR: {err_transverse*100.0:.1f}cm)"
                            self.last_result_color = (0, 255, 128)
                        self.last_result_sim_time = sim_time
                        self._pop_balloon()
                    else:
                        self.last_result_text = f"MISSED (ERR: {err_transverse*100.0:.1f}cm)"
                        self.last_result_color = (0, 0, 255)
                        self.last_result_sim_time = sim_time
                else:
                    self.last_result_text = "ENGAGEMENT COMPLETE"
                    self.last_result_color = (0, 215, 255)
                    self.last_result_sim_time = sim_time
            else:
                remaining_shots.append(shot)

        self.active_shots = remaining_shots

    def _get_balloon_position(self):
        """Balonun dunya koordinatlarindaki anlik 3D merkez noktasini dondurur."""
        if self.balloon_node:
            try:
                pos = self.balloon_node.getPosition()
                if pos:
                    # Balon geometrik ofsetleri (boundingObject translation)
                    # 1.5x olcekli gorsel balonun dunya geometrik ofsetleri (CAD v10 / mesh analizi):
                    # Robot rotasyonu [1, 0, 0, 1.5714] (X etrafinda 90 deg):
                    # obj mesh Z -> -dunya Y (-0.384m), obj mesh Y -> dunya Z (+0.185m), obj mesh X -> dunya X (-0.031m)
                    return [pos[0] - 0.033, pos[1] - 0.385, pos[2] + 0.255]
            except Exception:
                pass
        return None

    def _pop_balloon(self):
        """Balon dugumune POP sinyali gonderir; balloon_mover bunu patlamaya cevirir."""
        if not self.balloon_node:
            print("[BALISTIK] UYARI: BALLOON dugumu bulunamadi; patlama sinyali gonderilemedi.")
            return
        sent = False
        try:
            self.balloon_node.setCustomData("POP")
            sent = True
        except Exception:
            # Bazi Webots surumlerinde Node.setCustomData yoktur; alan uzerinden yaz.
            try:
                field = self.balloon_node.getField("customData")
                if field:
                    field.setSFString("POP")
                    sent = True
            except Exception:
                pass
        print("[BALISTIK] POP sinyali:", "GONDERILDI" if sent else "BASARISIZ")
