brkaysenturk/turret-fcs/turret_fcs/lock_manager.py

"""
================================================================================
MODUL: DINAMIK HEDEF KILIT YONETICISI (LOCK MANAGER)
================================================================================
Bu modul, atis kontrol sisteminin atesleme kapisi (Firing Gate) ve hedef kilit
kararliligini yonetir. Histerezisli cift esik mantigi ve analitik Gauss isabet
olasiligi modeli ile hedefe tam oturulmadan atis yapilmasini onler.

ALGORITMA VE GUCLU MEKANIZMALAR:
1. Histerezisli Dinamik Kilit Penceresi (Hysteresis Window):
   - Kilit Giris Esigi: Hedeften uzakliga ve hiza bagli dinamik esik (1.60° - 3.00°).
   - Kilit Cikis Esigi: Dinamik esik + 0.60° (2.20° - 3.60°).
   - Kilit Titremesi Onleme: Hedef tam esik cizgisinde hareket ederken kilidin
     anlik acilip kapanmasini (chattering / flickering) onler.
2. Kararlilik Sayaci (Stability Counter):
   - Hedef kilit penceresine girdikten sonra art arda 10 kare (~0.33 sn) boyunca
     pencere icinde kalmasi zorunludur. Anlik hedef gecislerinde atis yapilmaz.
3. Analitik Gauss Isabet Olasiligi Modeli (Hit Probability):
   - Tam 2B Dairesel Gauss Integrali (Merkezi Olmayan Ki-Kare CDF / Marcum Q) ile
     hedef geometrisi, ucus suresi, gecikme ve sacilmaya gore %0.0 - %100.0 arasi hesaplar.
================================================================================
"""

import numpy as np
from scipy.special import chndtr


from .config import CONFIG


class LockManager:
    """
    Dinamik kilit acimini, histerezis esiklerini, kararlilik sayacini ve
    hedef kilit kalitesi puanini gercek zamanli turret FCS icin yonetir.
    """

    def __init__(
        self,
        lock_threshold_frames=CONFIG.lock.lock_threshold_frames,
        lock_exit_margin_deg=CONFIG.lock.lock_exit_margin_deg,
        fx=None,
    ):
        self.lock_threshold_frames = lock_threshold_frames
        self.lock_exit_margin_deg = lock_exit_margin_deg
        self.fx = float(fx) if fx is not None else CONFIG.optics.compute_fx(CONFIG.optics.default_width)
        self.fy = CONFIG.optics.compute_fy(CONFIG.optics.default_height)
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
