brkaysenturk/turret-fcs/(commit log)

2026-10-05 feat: initial commit - Turret FCS autonomous targeting, Webots simulation, and STM32 firmware
    Initial release of Turret FCS autonomous targeting, Webots simulation, and STM32 firmware.
    Include MIT license and clean repository structure.
2026-10-08 refactor(arch): enforce SSOT architecture and modular component interfaces across FCSManager
    Align default controller gains, calibrate smooth Lissajous patrol baseline, and enforce SSOT architecture across FCSManager.
2026-10-08 feat(stm32): add STM32 Nucleo firmware project and allow numpy>=2.0 compatibility
    Add STM32 Nucleo firmware project and allow numpy>=2.0 for scipy and ultralytics compatibility.
2026-10-11 feat(hardware): add 3D CAD mechanical assembly renders and update architecture documentation
    Add 3D CAD mechanical assembly renders and update system architecture documentation with 4K diagrams.
2026-10-13 feat(release): v1.0.0 - 3-stage circular patrol, MIL-STD tactical HUD event log, and unified sensor fusion architecture
    Integrate P/RL hybrid controller, ego-motion Kalman filter, C270 optics, and 300 DPI analysis figures.
    Production-ready Turret FCS with calm 3-stage circular patrol and SSOT Event Log HUD.
2026-10-14 feat(v1.1): 2-DOF velocity feedforward, pipeline-aligned PPO RL, and multi-tier fail-safe architecture
    Add 2-DOF velocity feedforward, pipeline-aligned PPO RL, and multi-tier fail-safe architecture.
2026-10-14 feat(v1.1): add 1st-order actuator observer for ego-motion compensation and project memory
    Add 1st-order actuator observer for ego-motion compensation and synchronize UART docstring.
    Add MIT license and academic architecture diagrams.
2026-10-20 feat(analysis): synchronize system identification, plant dynamics, and 300 dpi benchmark figures
    Standardize calibration comments, replace obsolete simulation seed plots with live hardware benchmarks, and synchronize system identification models.
2026-10-20 feat(patrol): overhaul airspace patrol with odometry RTB and add interactive camera calibration
    Overhaul airspace patrol with odometry return-to-center, wide 45x16 angles, and add interactive camera calibration tool for 55 deg dFOV standard.
2026-10-20 feat(control): add step accumulator for patrol RTB and dynamic velocity deadband
    Add step accumulator for patrol RTB and dynamic Kalman velocity deadband.
2026-10-21 feat(telemetry): implement telemetry v2 with hardware odometry sync and JSON metadata sidecar
    Establish SSOT configuration, package structure, repository hygiene, and implement telemetry v2 with hardware odometry sync and JSON metadata sidecar.
2026-10-21 feat(ballistics): implement exact 2D Gauss hit probability, aim-point feedforward, and CWNA Kalman calibration
    Calibrate adaptive CWNA Kalman filter, Type-1 P controller, and implement exact 2D Gauss hit probability with direct aim-point feedforward.
2026-10-21 test(ci): implement comprehensive pytest suite, GitHub Actions CI, and decouple STM32 watchdog
    Decouple STM32 telemetry from LiDAR, make watchdog unconditional, add atomic command read, and implement 19-case pytest suite with CI workflow.
2026-10-25 feat(tracking): add candidate-replay Kalman outlier gate, sliding-window UART resync, and ego prediction
    Add sliding-window 0xAA header resynchronization on UART checksum mismatch.
    Add candidate-replay Kalman outlier gate, confidence-weighted target selection, dropout prediction, and centralize constants in CONFIG.
2026-10-25 feat(kalman): redesign CV filter with single-spike outlier gate and unify production Type-1 P controller
    Redesign CV Kalman filter with 150 px single-spike outlier gate and tracking hysteresis.
    Unify production Type-1 P and pure PPO RL controllers with dynamic acceleration limits.
2026-10-25 feat(rl): add 1.20 deg backlash plant model, progress reward, v14 PPO policy, and modular FCS stack
    Add 1.20 deg backlash plant model, progress reward, v14 PPO policy, and extract engagement FSM, HUD presenter, keymap, and binary protocol SSOT.
2026-10-25 feat(firmware): add HAL IWDG watchdog, rate-limited E-stop homing, and synchronize Webots digital twin
    Add HAL IWDG watchdog, rate-limited E-stop homing, protocol header, and unify digital twin with production FCS stack and profile-bounded tuning.
2026-10-25 feat(control): finalize Bayesian-optimized P/RL production controllers with empirical EVT selector
    Finalize v2.1 Bayesian-optimized P and PPO RL production controllers.
    Integrate empirical EVT selector, Monte Carlo lock thresholds, and resolve motor maxVelocity limits.
2026-10-25 feat(control): optimize Type-1 P controller on 1.61 deg backlash plant and restore proven hardware stability
    Optimize Type-1 P controller parameters via multivariate Optuna TPE on 1.61 deg backlash plant, synchronize architecture in README, and restore proven smooth parameters for hardware stability.
2026-10-27 fix(fcs): tighten Kalman outlier gate, audit benchmark scripts, and synchronize Section 5 SSOT
    Tighten Kalman outlier gate, refine dt handling, audit and correct benchmark scripts, align MATLAB plant model with production SSOT, and update Section 5 SSOT in AGENTS.md.
2026-11-03 feat(fcs): calibrate CAD v10 parallax compensation, transverse impact analysis, and multi-distance tracking benchmarks
2026-11-03 feat(system): standardize dual stm32 firmware, flywheel engagement control, and unified clean cli/hud
2026-11-05 feat(comm): expand FCS command frame to 8 bytes and support dynamic flywheel speed
